felixlu4725/Carte-Diem/cart_tracking/cart1raw_path.png

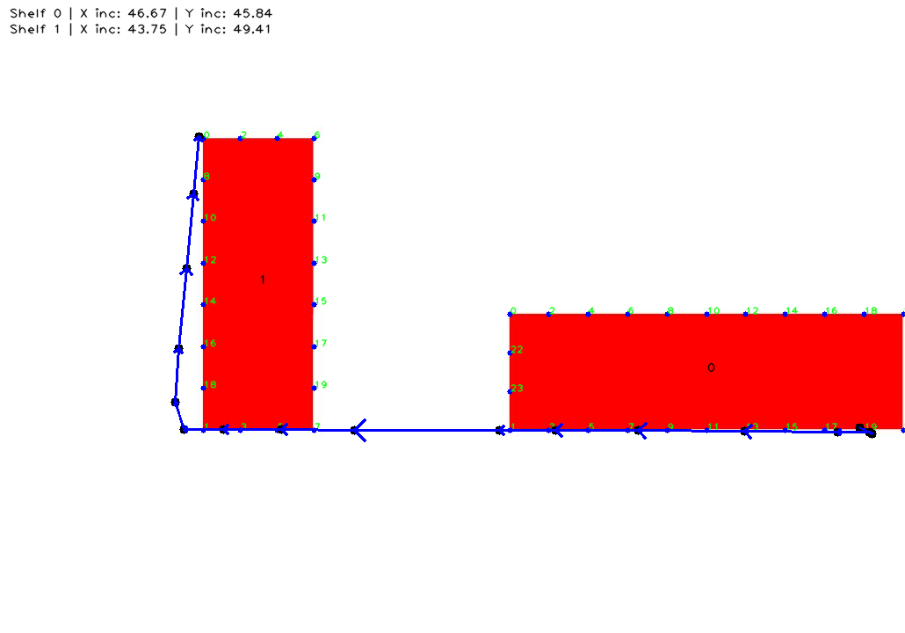
cart_tracking/cart1raw_path.png
