felixlu4725/Carte-Diem/cart_tracking/cart_heat_map.png

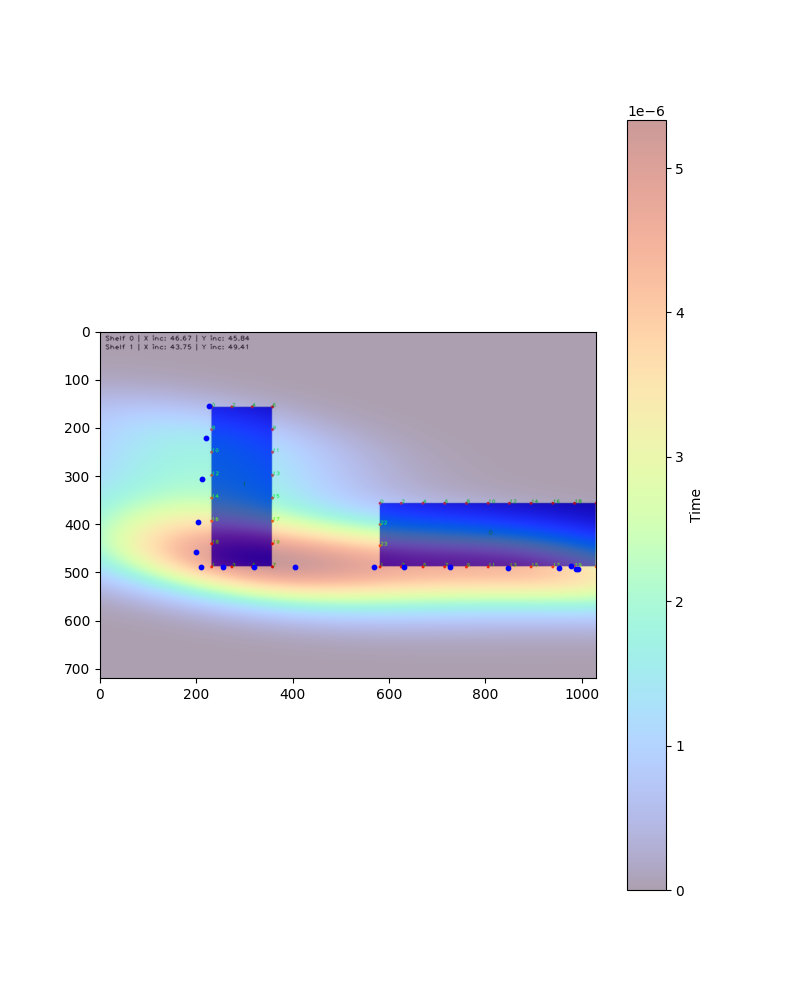
cart_tracking/cart_heat_map.png
