felixlu4725/Carte-Diem/cart_tracking/combined_heat_map.png

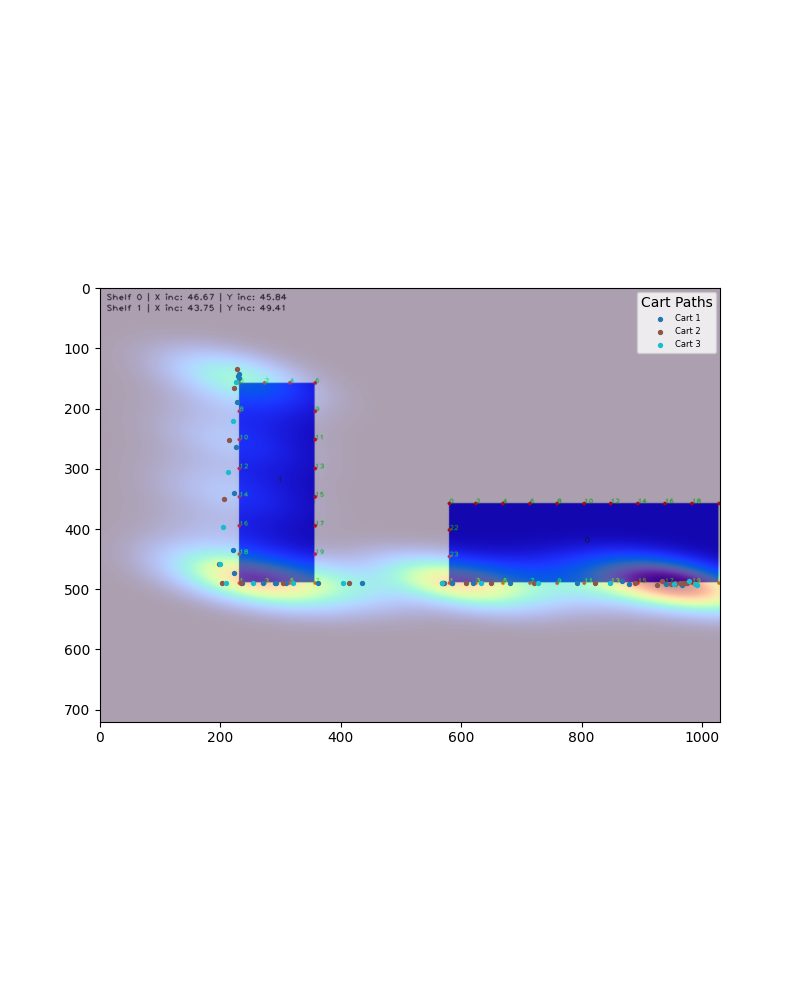
cart_tracking/combined_heat_map.png
