felixlu4725/Carte-Diem/cart_tracking/grocery_store.png

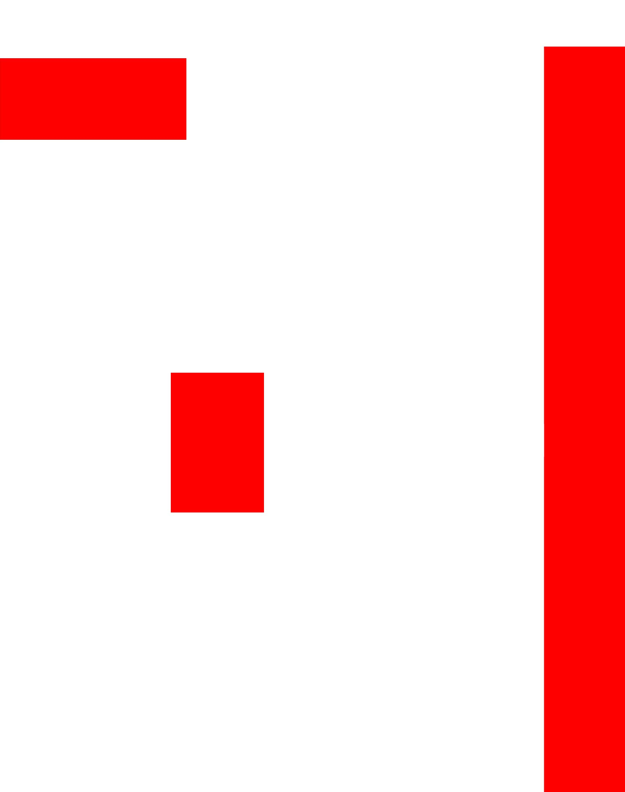
cart_tracking/grocery_store.png
