felixlu4725/Carte-Diem/cart_tracking/mapped.jpg

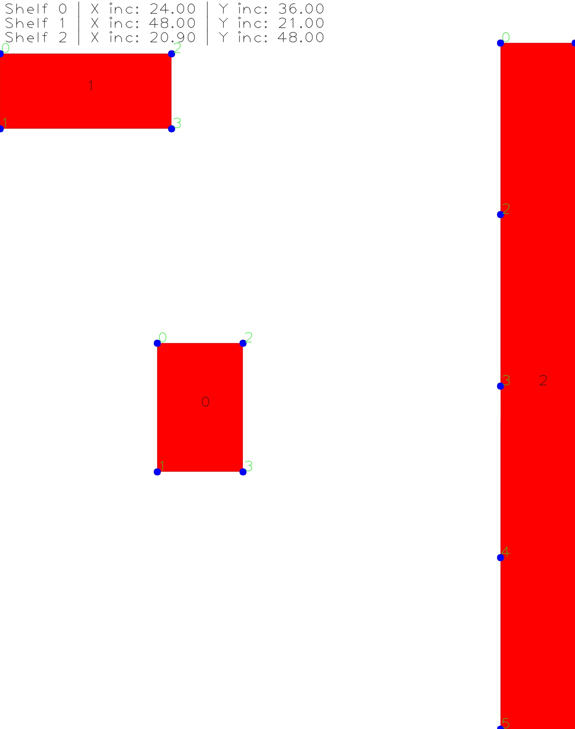
cart_tracking/mapped.jpg
