felixlu4725/Carte-Diem/cart_tracking/store1.png

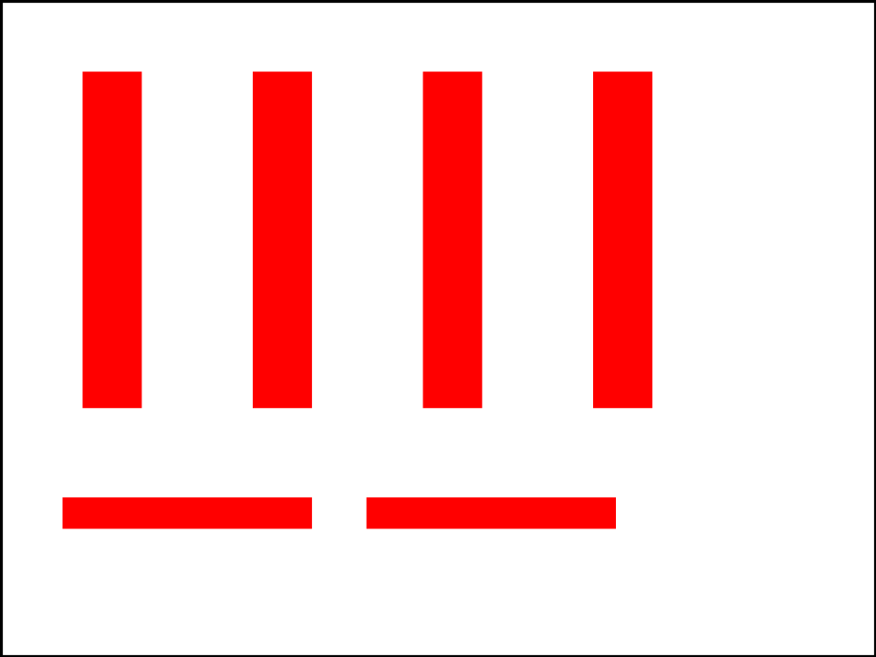
cart_tracking/store1.png
