felixlu4725/Carte-Diem/cart_tracking/store2.png

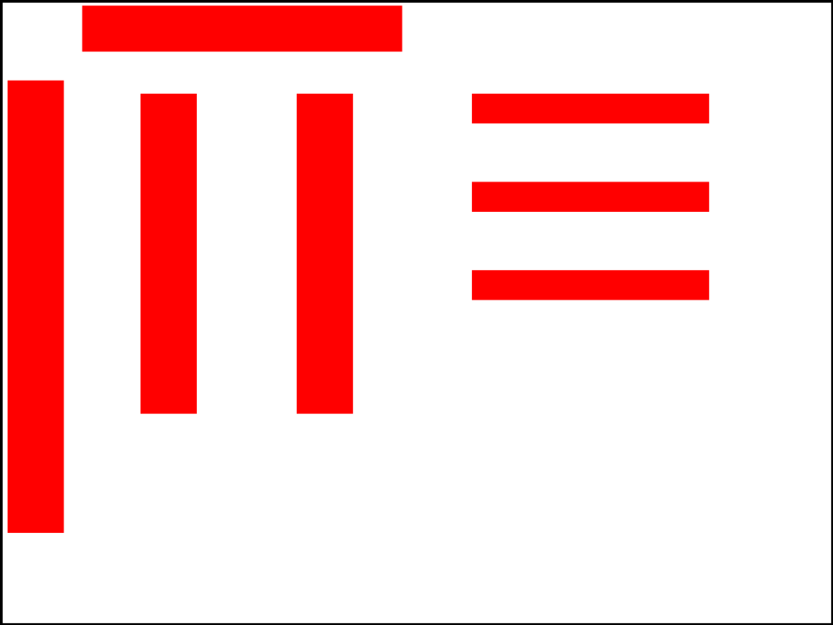
cart_tracking/store2.png
