felixlu4725/Carte-Diem/cart_tracking/store3.png

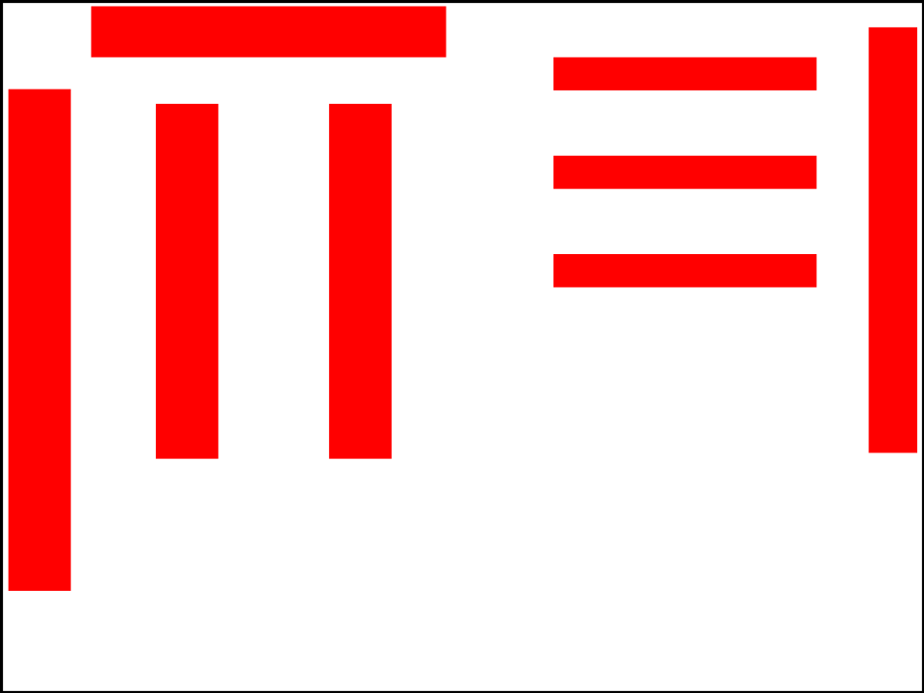
cart_tracking/store3.png
