felixlu4725/Carte-Diem/CAD/Hand Scanner Final.step

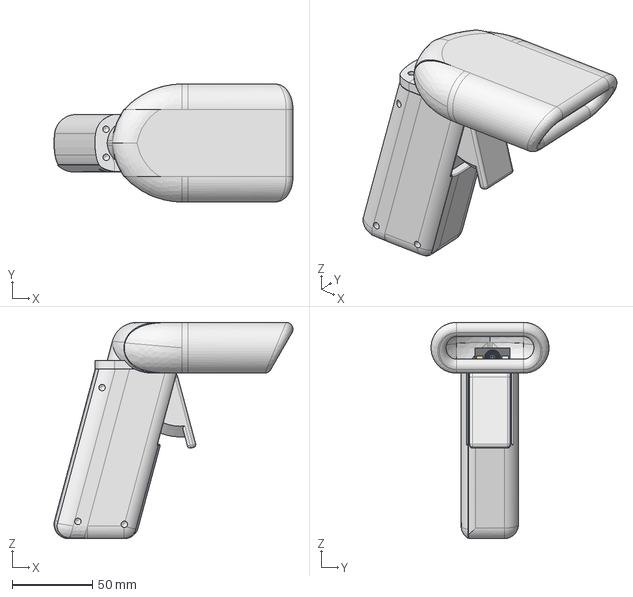
[picture p11: CAD file, 2025-12-08]
CAD/Hand Scanner Final.step
149.0 x 73.6 x 134.8 mm
