felixlu4725/Carte-Diem/PCB/Custom_Library/StepFiles/LT1764AEQPBF.step

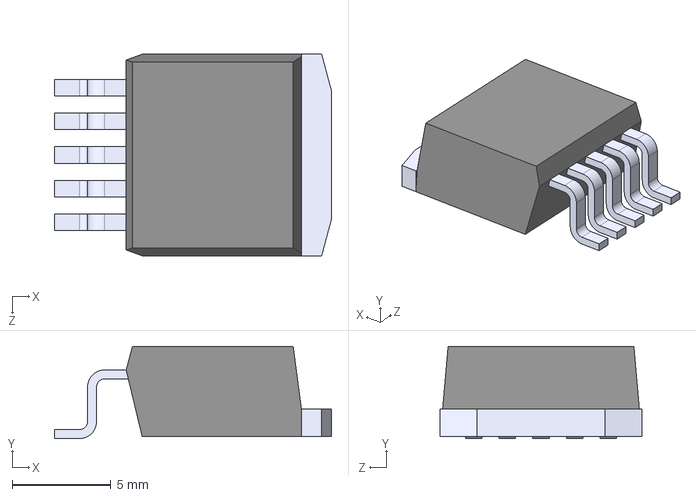
[picture p12: CAD file, 2025-12-08]
PCB/Custom_Library/StepFiles/LT1764AEQPBF.step
14.0 x 4.67 x 10.2 mm
