felixlu4725/Carte-Diem/PCB/Custom_Library/StepFiles/USB4120-03-C_REVA.step

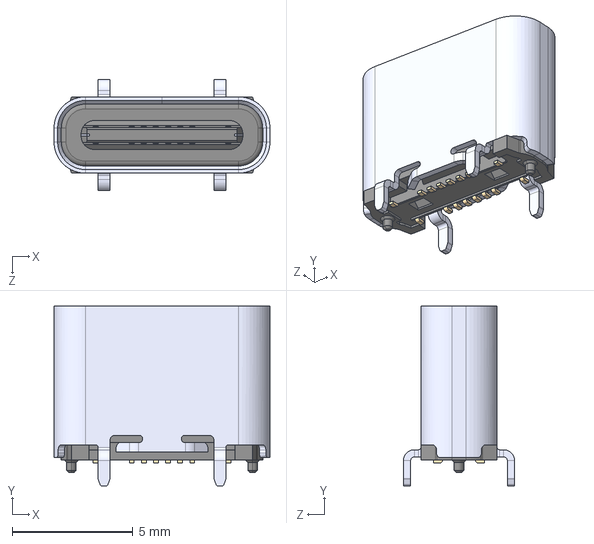
[picture p13: CAD file, 2025-12-08]
PCB/Custom_Library/StepFiles/USB4120-03-C_REVA.step
8.94 x 7.45 x 4.60 mm
