felixlu4725/Carte-Diem/PCB/Custom_Library/StepFiles/MF-MSMF010-2.step

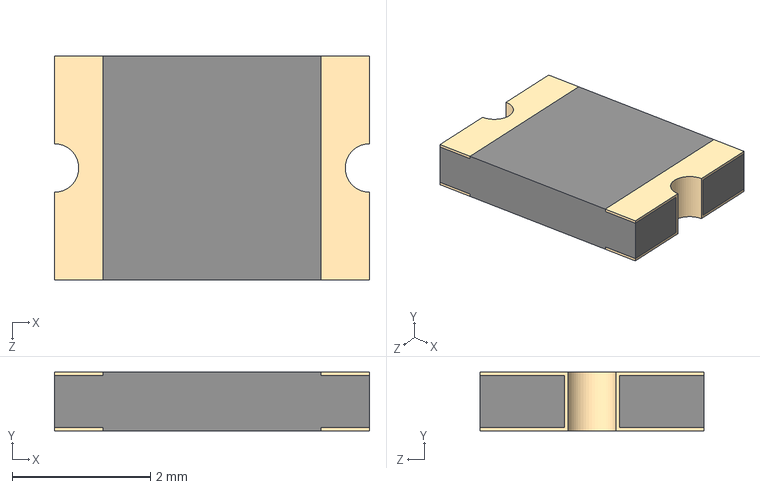
[picture p14: CAD file, 2025-12-08]
PCB/Custom_Library/StepFiles/MF-MSMF010-2.step
4.55 x 0.85 x 3.24 mm
