felixlu4725/Carte-Diem/PCB/Custom_Library/StepFiles/XT60PW-M.step

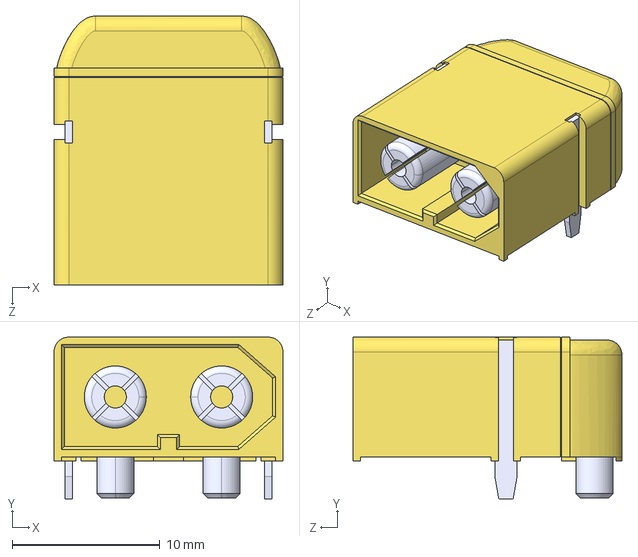
[picture p15: CAD file, 2025-12-08]
PCB/Custom_Library/StepFiles/XT60PW-M.step
15.5 x 10.9 x 18.2 mm
