felixlu4725/Carte-Diem/PCB/Custom_Library/StepFiles/USB4105GFA.step

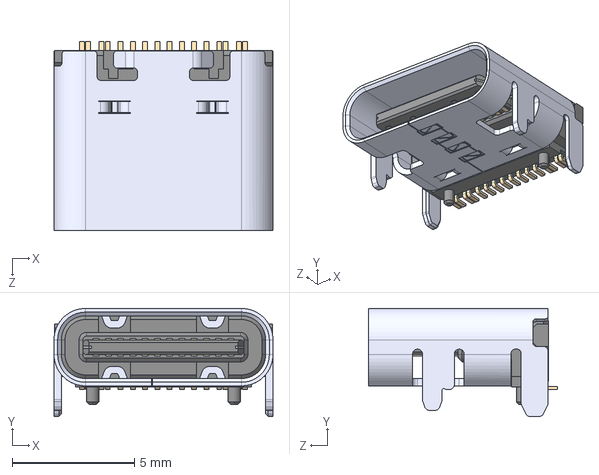
[picture p16: CAD file, 2025-12-08]
PCB/Custom_Library/StepFiles/USB4105GFA.step
8.94 x 4.41 x 7.71 mm
