felixlu4725/Carte-Diem/PCB/Custom_Library/StepFiles/SO14_DIO.step

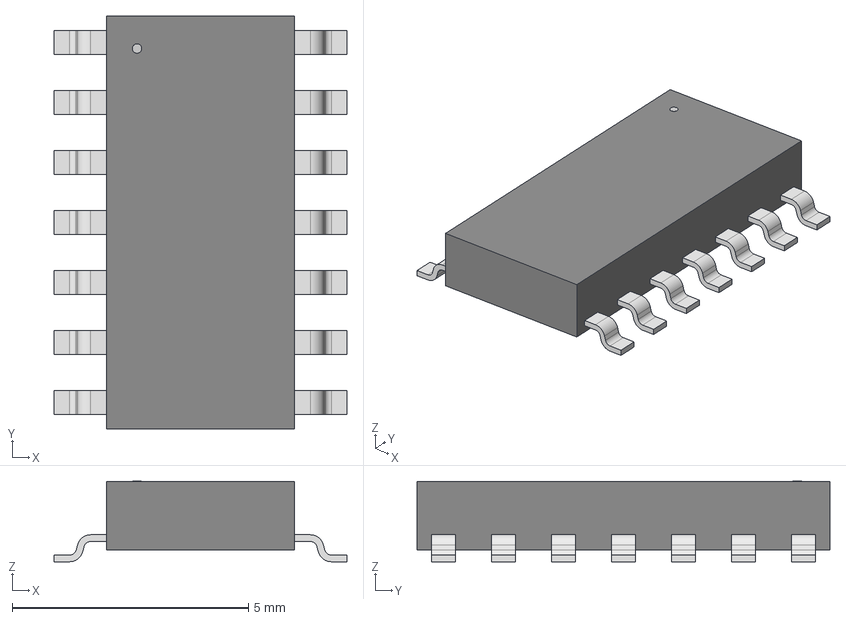
[picture p17: CAD file, 2025-12-08]
PCB/Custom_Library/StepFiles/SO14_DIO.step
6.20 x 8.74 x 1.70 mm
