felixlu4725/Carte-Diem/cart_tracking/test.bmp

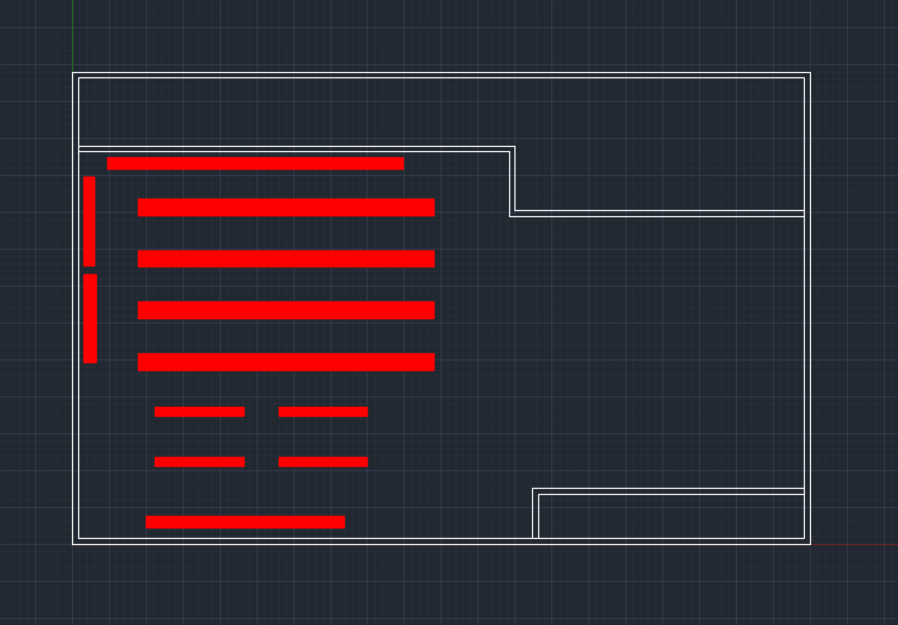
cart_tracking/test.bmp
