felixlu4725/Carte-Diem/cart_tracking/test-Model.pdf

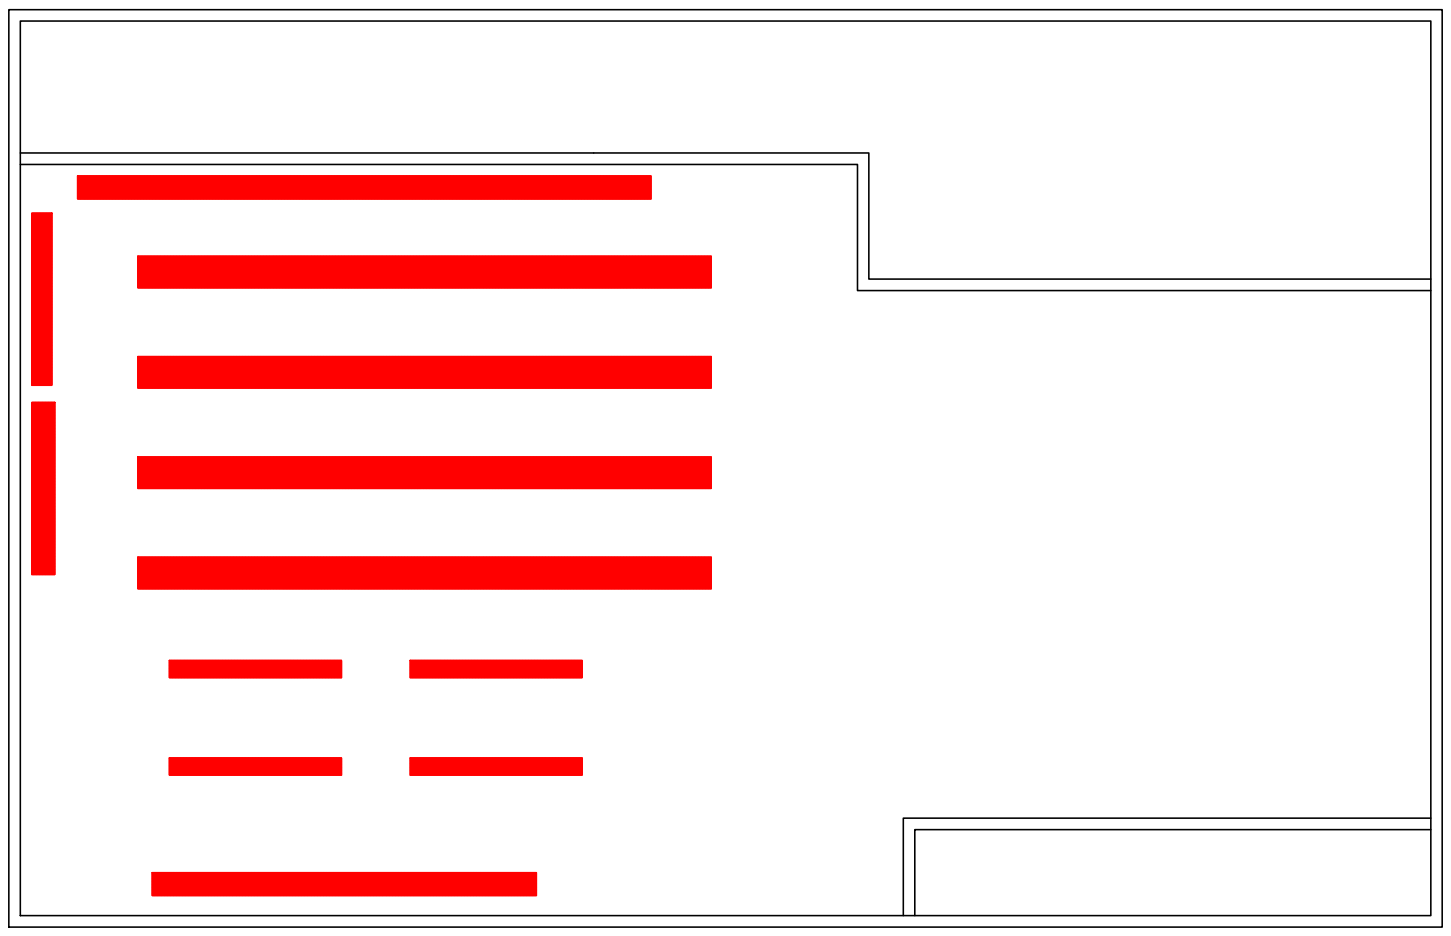
[picture p19: page 1]
