felixlu4725/Carte-Diem/PCB/CartDiem_STM.kicad_pcb

## KiCad design PCB/CartDiem_STM.kicad_pcb (2025-12-08)

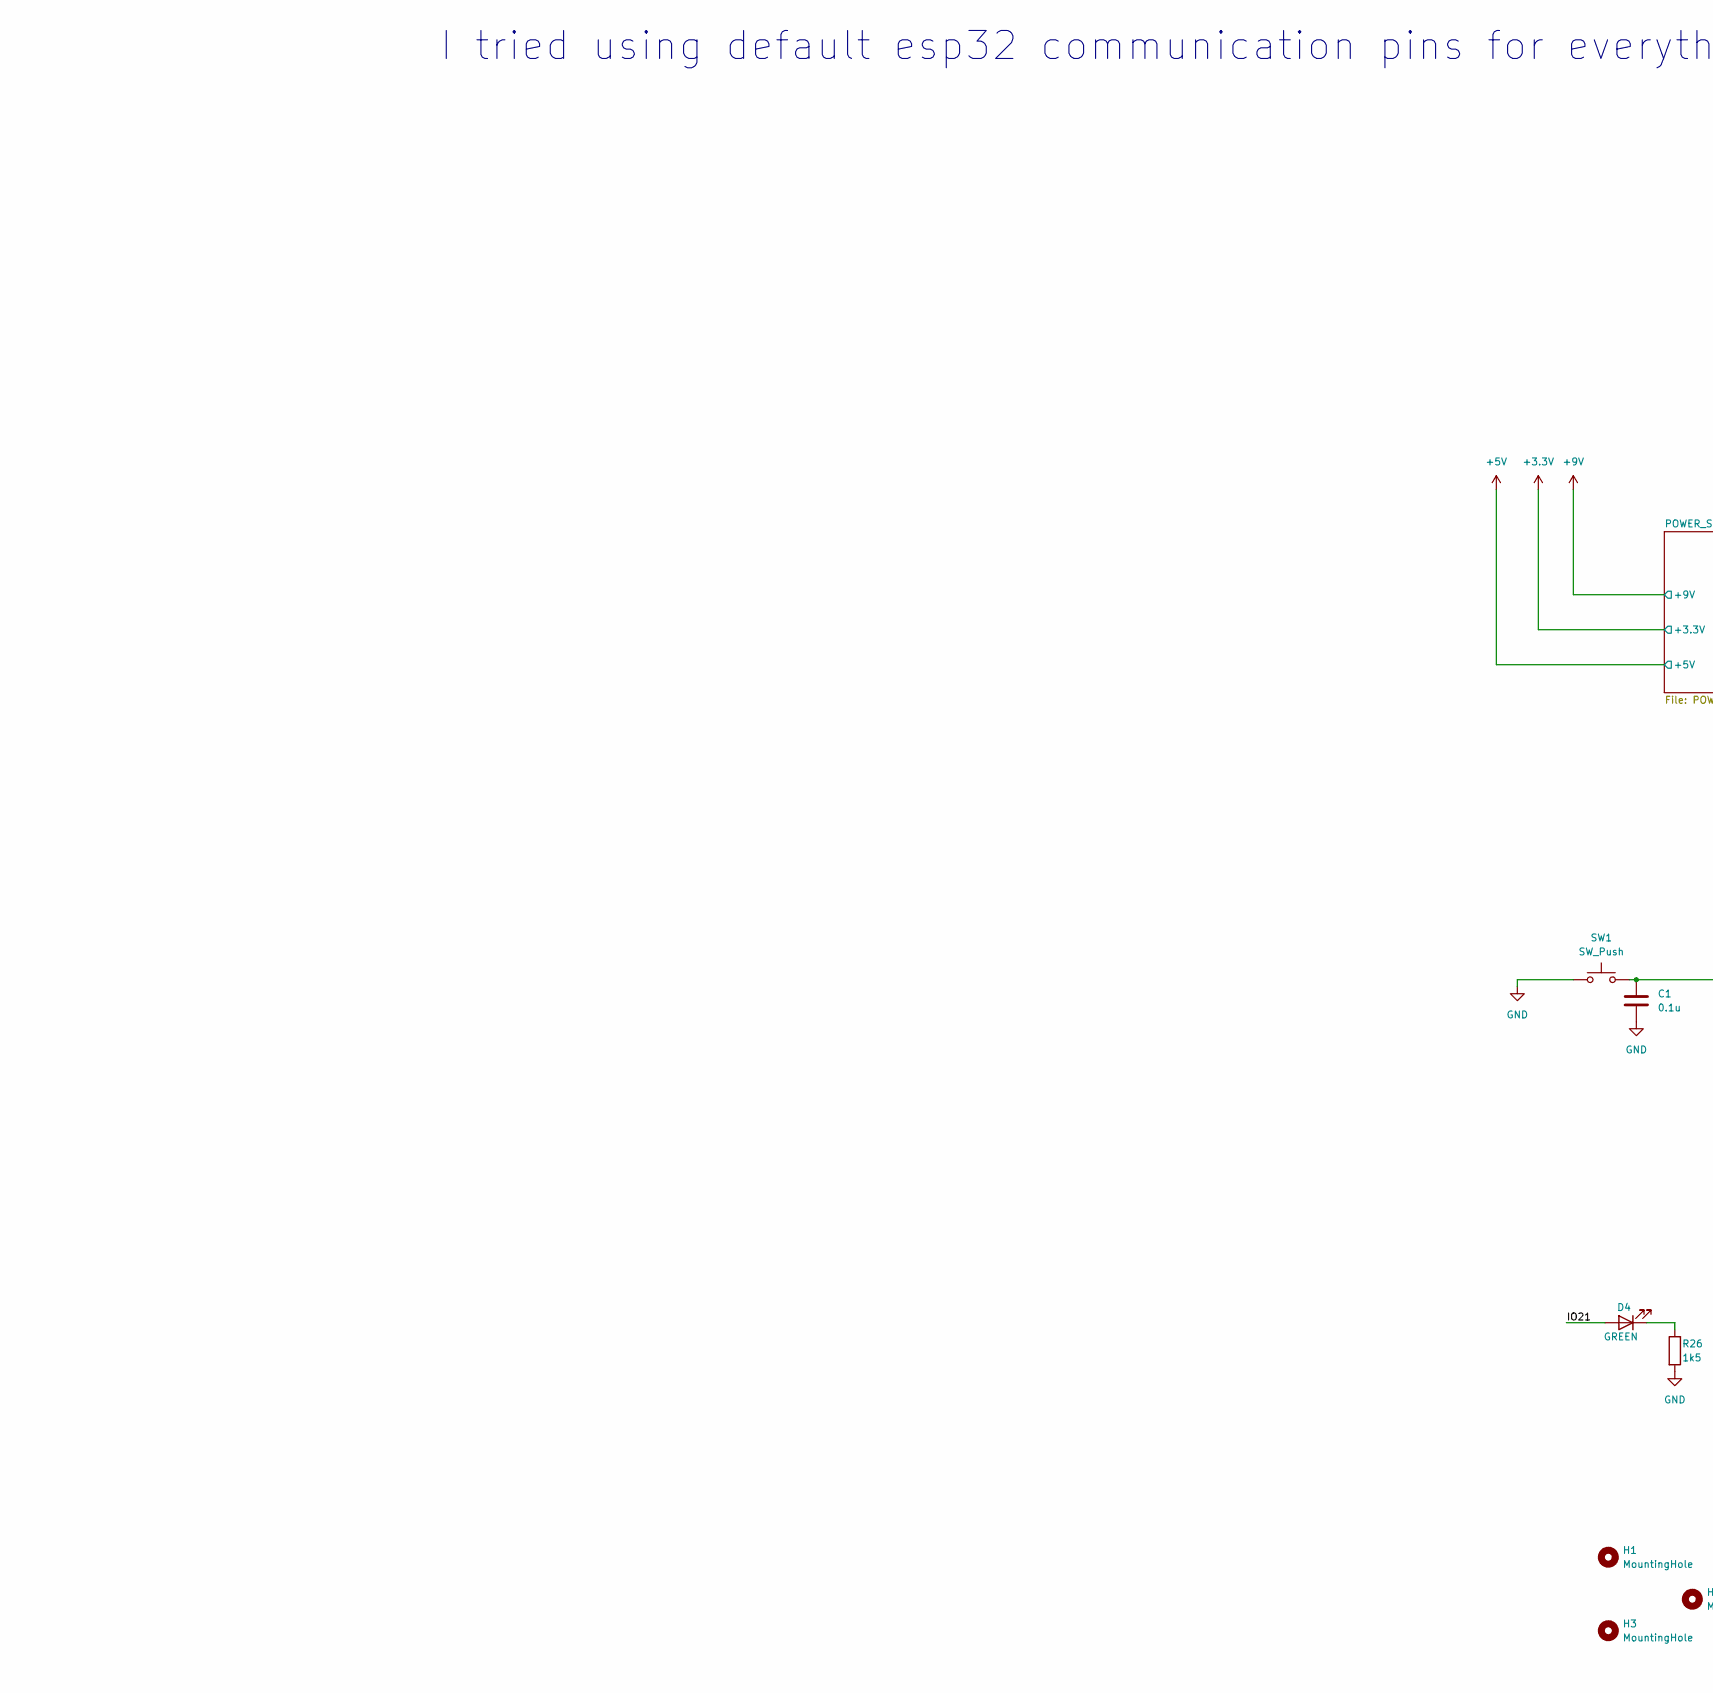
[picture p20: schematic CartDiem_STM.kicad_sch, part in row 1, column 1]

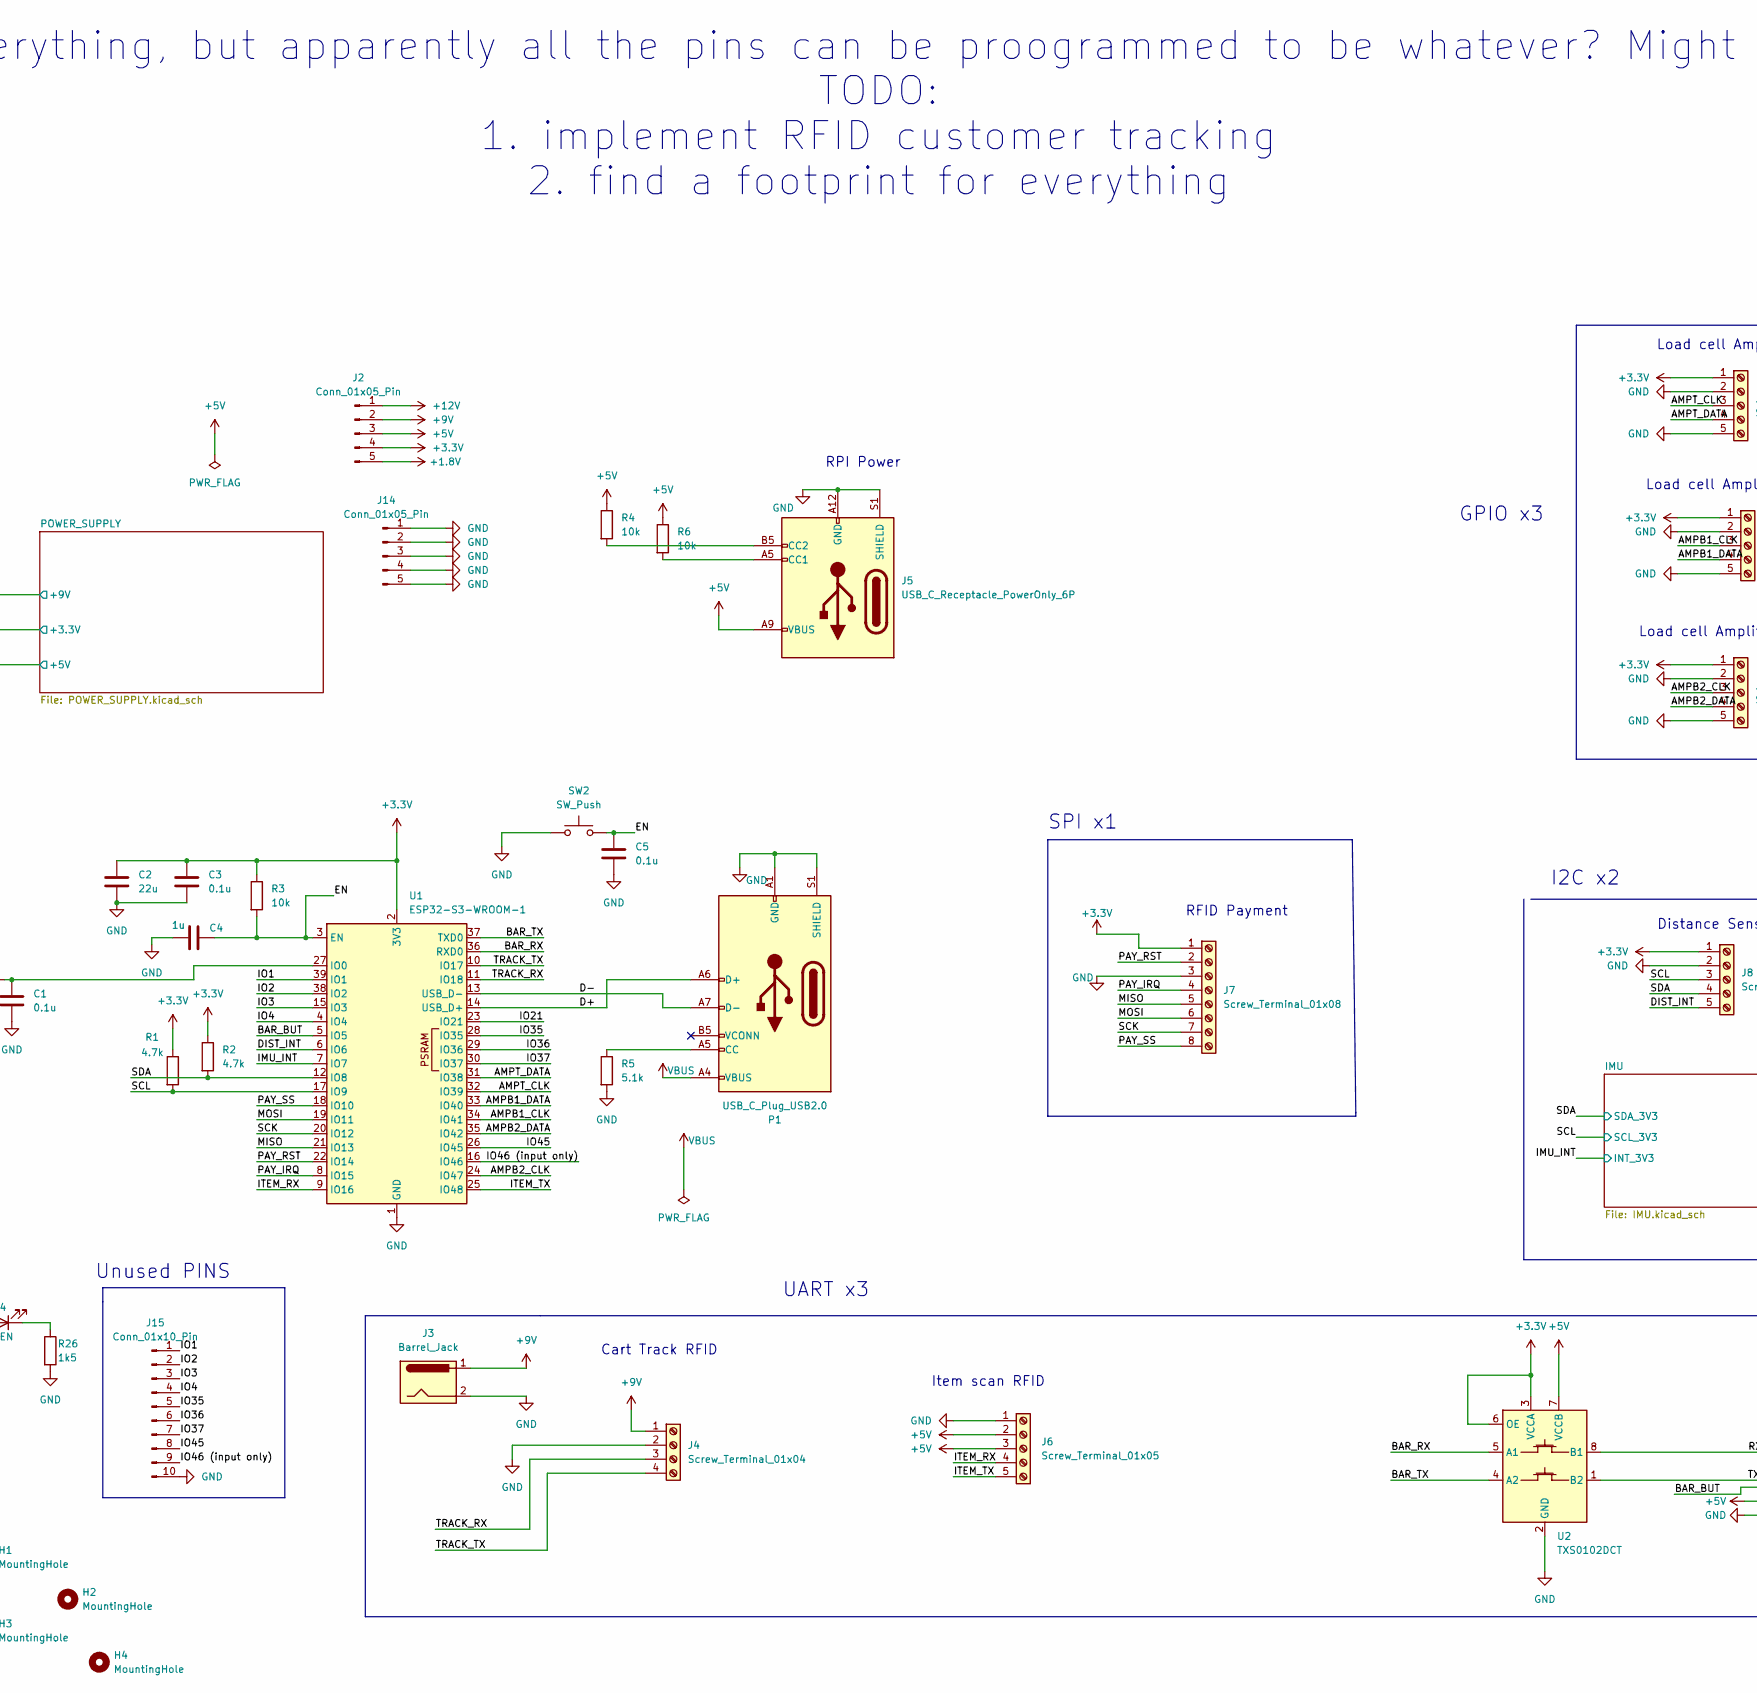
[picture p21: schematic CartDiem_STM.kicad_sch, part in row 1, column 2]

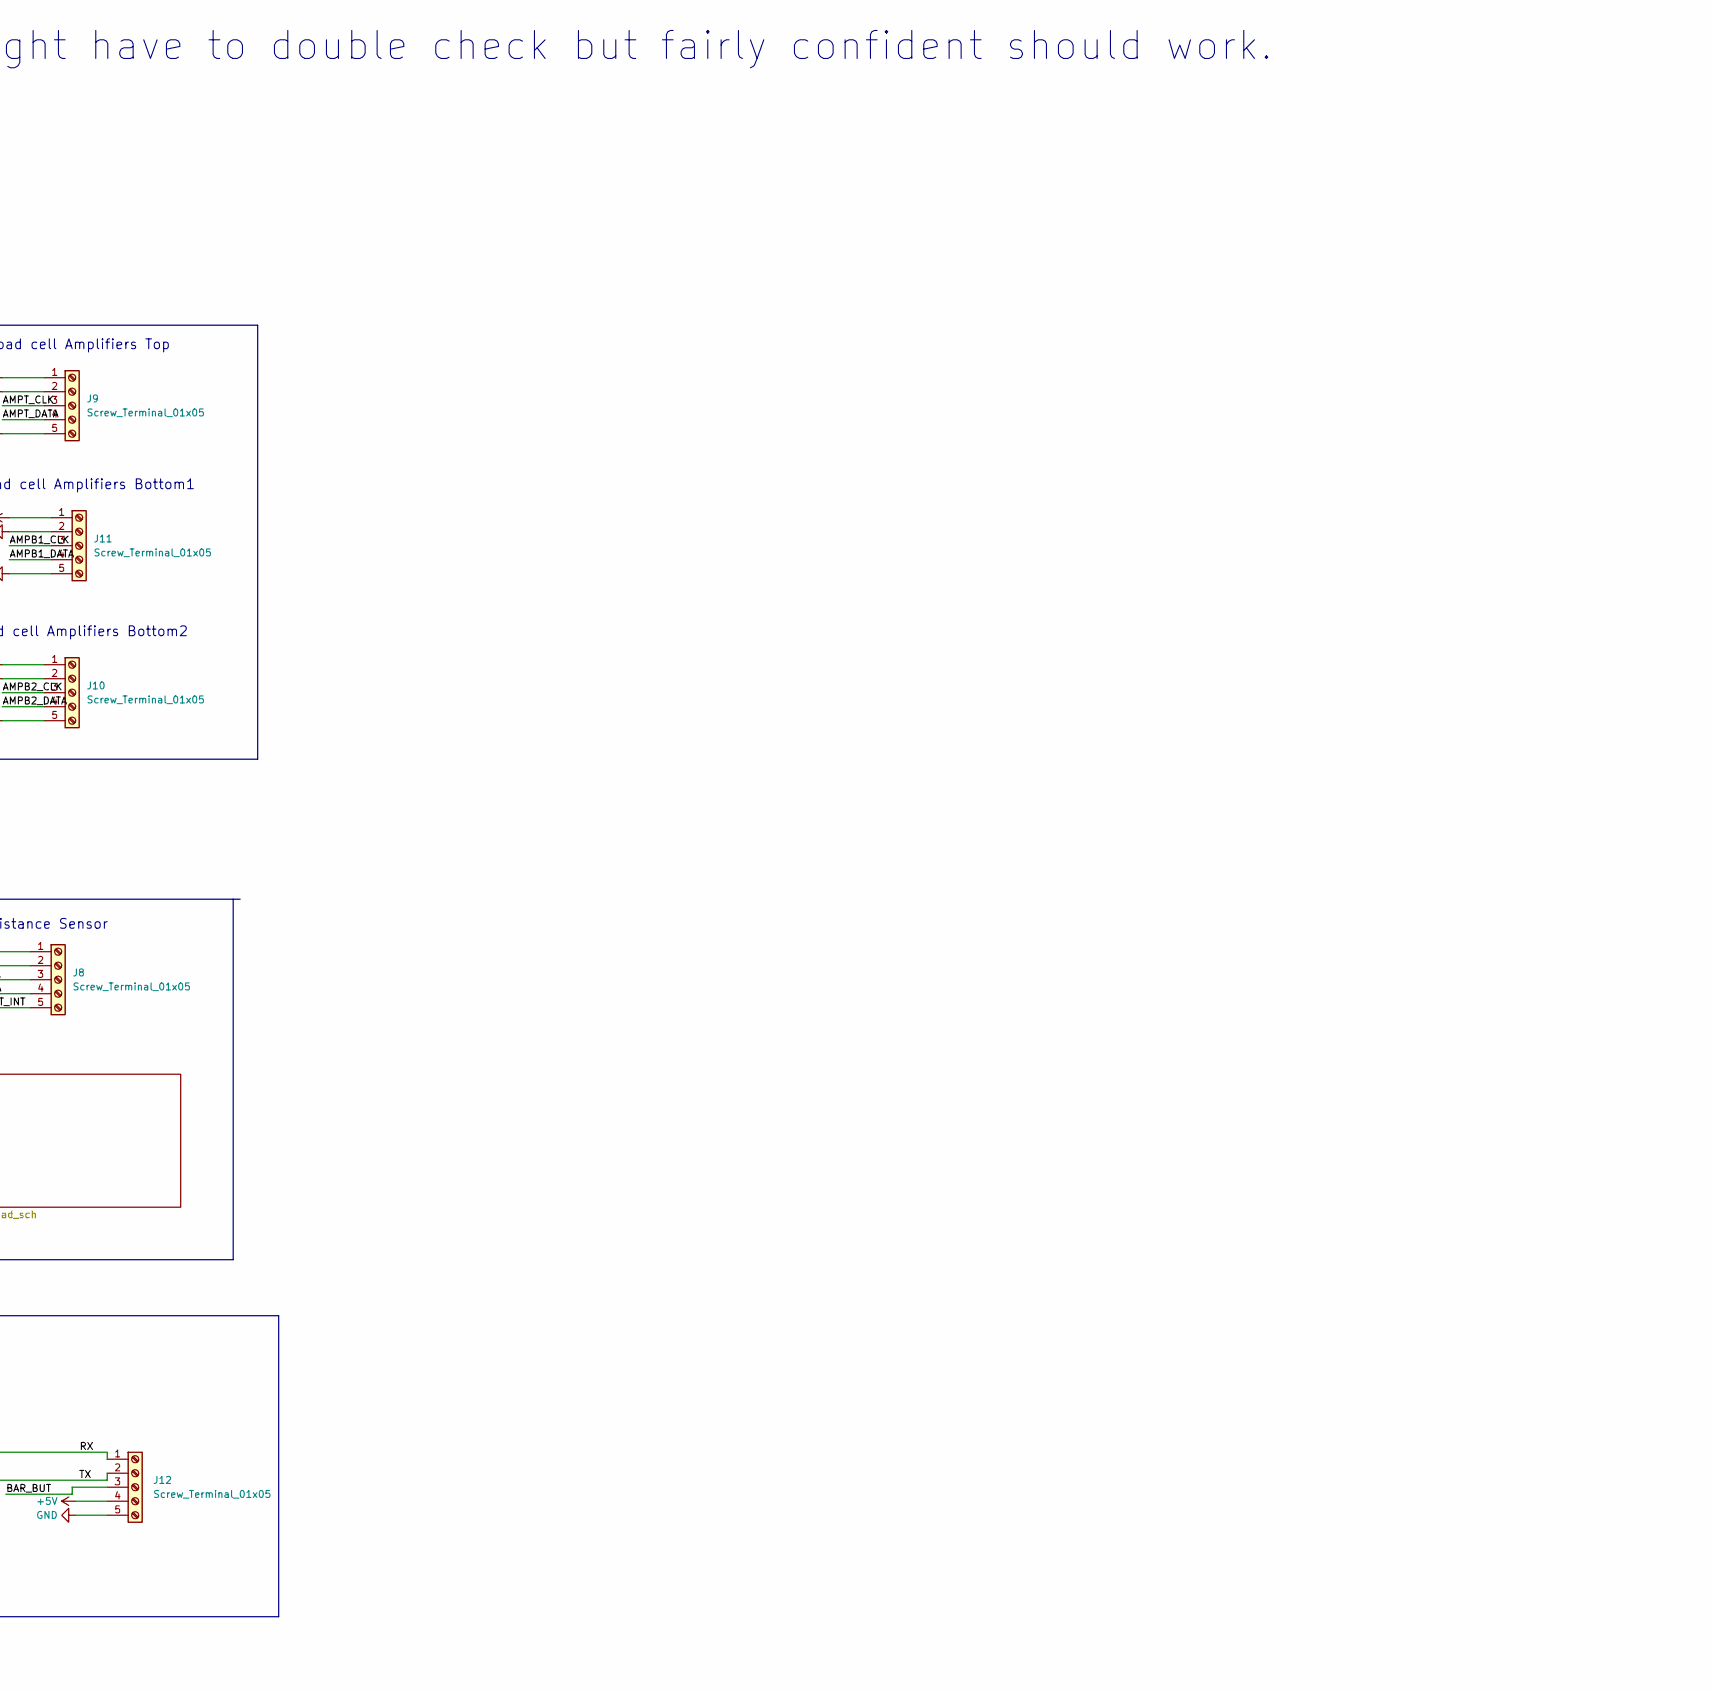
[picture p22: schematic CartDiem_STM.kicad_sch, part in row 1, column 3]

Parts:
C1, C3, C5: 0.1u; C_0603_1608Metric
C2: 22u; C_1210_3225Metric
C4: 1u; C_0603_1608Metric
D4: GREEN; LED_0603_1608Metric
H1, H2, H3, H4: MountingHole; MountingHole_3.2mm_M3
J2, J14: Conn_01x05_Pin; PinHeader_1x05_P2.54mm_Vertical
J3: Barrel_Jack; BarrelJack_CUI_PJ-063AH_Horizontal
J4: Screw_Terminal_01x04; TerminalBlock_Xinya_XY308-2.54-4P_1x04_P2.54mm_Horizontal
J5: USB_C_Receptacle_PowerOnly_6P; USB_C_Receptacle_GCT_USB4125-xx-x-0190_6P_TopMnt_Horizontal
J6, J8, J9, J10, J11, J12: Screw_Terminal_01x05; TerminalBlock_Xinya_XY308-2.54-5P_1x05_P2.54mm_Horizontal
J7: Screw_Terminal_01x08; TerminalBlock_Xinya_XY308-2.54-8P_1x08_P2.54mm_Horizontal
J15: Conn_01x10_Pin; PinHeader_1x10_P2.54mm_Vertical
P1: USB_C_Plug_USB2.0; GCT_USB4120-03-C_REVA
R1, R2: 4.7k; R_0603_1608Metric
R3, R4, R6: 10k; R_0603_1608Metric
R5: 5.1k; R_0603_1608Metric
R26: 1k5; R_0603_1608Metric
SW1, SW2: SW_Push; SW_Push_1P1T_XKB_TS-1187A
U1: ESP32-S3-WROOM-1
U2: TXS0102DCT; SSOP-8_2.95x2.8mm_P0.65mm

Connections:
+1.8V: J2.5; also elsewhere on the board
+3.3V: C2.1, C3.1, J2.4, J7.1, J8.1, J9.1, J10.1, J11.1, R1.1, R2.1, R3.1, U1.2 (3V3), U2.3 (VCCA), U2.6 (OE); also elsewhere on the board
+5V: J2.3, J5.A9 (VBUS), J5.B9 (VBUS), J6.2, J6.3, J12.4, R4.1, R6.1, U2.7 (VCCB); also elsewhere on the board
+9V: J2.2, J3.1, J4.1; also elsewhere on the board
+12V: J2.1; also elsewhere on the board
/AMPB1_CLK: J11.3, U1.34 (IO41)
/AMPB1_DATA: J11.4, U1.33 (IO40)
/AMPB2_CLK: J10.3, U1.24 (IO47)
/AMPB2_DATA: J10.4, U1.35 (IO42)
/AMPT_CLK: J9.3, U1.32 (IO39)
/AMPT_DATA: J9.4, U1.31 (IO38)
/BAR_BUT: J12.3, U1.5 (IO5)
/BAR_RX: U1.36 (RXD0), U2.5 (A1)
/BAR_TX: U1.37 (TXD0), U2.4 (A2)
/D+: P1.A6 (D+), U1.14 (USB_D+)
/D-: P1.A7 (D-), U1.13 (USB_D-)
/DIST_INT: J8.5, U1.6 (IO6)
/EN: C4.2, C5.1, R3.2, SW2.2, U1.3 (EN)
/IMU_INT: U1.7 (IO7); also elsewhere on the board
/IO1: J15.1, U1.39 (IO1)
/IO2: J15.2, U1.38 (IO2)
/IO3: J15.3, U1.15 (IO3)
/IO4: J15.4, U1.4 (IO4)
/IO21: D4.2 (A), U1.23 (IO21)
/IO35: J15.5, U1.28 (IO35)
/IO36: J15.6, U1.29 (IO36)
/IO37: J15.7, U1.30 (IO37)
/IO45: J15.8, U1.26 (IO45)
/IO46 (input only): J15.9, U1.16 (IO46)
/ITEM_RX: J6.4, U1.9 (IO16)
/ITEM_TX: J6.5, U1.25 (IO48)
/MISO: J7.5, U1.21 (IO13)
/MOSI: J7.6, U1.19 (IO11)
/PAY_IRQ: J7.4, U1.8 (IO15)
/PAY_RST: J7.2, U1.22 (IO14)
/PAY_SS: J7.8, U1.18 (IO10)
/RX: J12.1, U2.8 (B1)
/SCK: J7.7, U1.20 (IO12)
/SCL: J8.3, R1.2, U1.17 (IO9); also elsewhere on the board
/SDA: J8.4, R2.2, U1.12 (IO8); also elsewhere on the board
/TRACK_RX: J4.3, U1.11 (IO18)
/TRACK_TX: J4.4, U1.10 (IO17)
/TX: J12.2, U2.1 (B2)
GND: C1.2, C2.2, C3.2, C4.1, C5.2, J3.2, J4.2, J5.A12 (GND), J5.B12 (GND), J5.S1 (SHIELD), J6.1, J7.3, J8.2, J9.2, J9.5, J10.2, J10.5, J11.2, J11.5, J12.5, J14.1, J14.2, J14.3, J14.4, J14.5, J15.10, P1.A1 (GND), P1.A12 (GND), P1.B1 (GND), P1.B12 (GND), P1.S1 (SHIELD), R5.2, R26.2, SW1.1, SW2.1, U1.1 (GND), U1.40 (GND), U1.41 (GND), U2.2 (GND); also elsewhere on the board
unnamed: D4.1 (K), R26.1
unnamed: J5.A5 (CC1), R6.2
unnamed: J5.B5 (CC2), R4.2
unnamed: P1.A5 (CC), R5.1
unnamed: C1.1, SW1.2, U1.27 (IO0)
VBUS: P1.A4 (VBUS), P1.A9 (VBUS), P1.B4 (VBUS), P1.B9 (VBUS); also elsewhere on the board

Notes on the sheet:
Item scan RFID
Unused PINS
Load cell Amplifiers Bottom2
RFID Payment
Cart Track RFID
Distance Sensor
SPI x1
Load cell Amplifiers Bottom1
UART x3
I tried using default esp32 communication pins for everything, but apparently all the pins can be proogrammed to be whatever? Might have to double check but fairly confident should work. TODO: 1. implement RFID customer tracking 2. find a footprint for everything
Load cell Amplifiers Top
GPIO x3
RPI Power
I2C x2

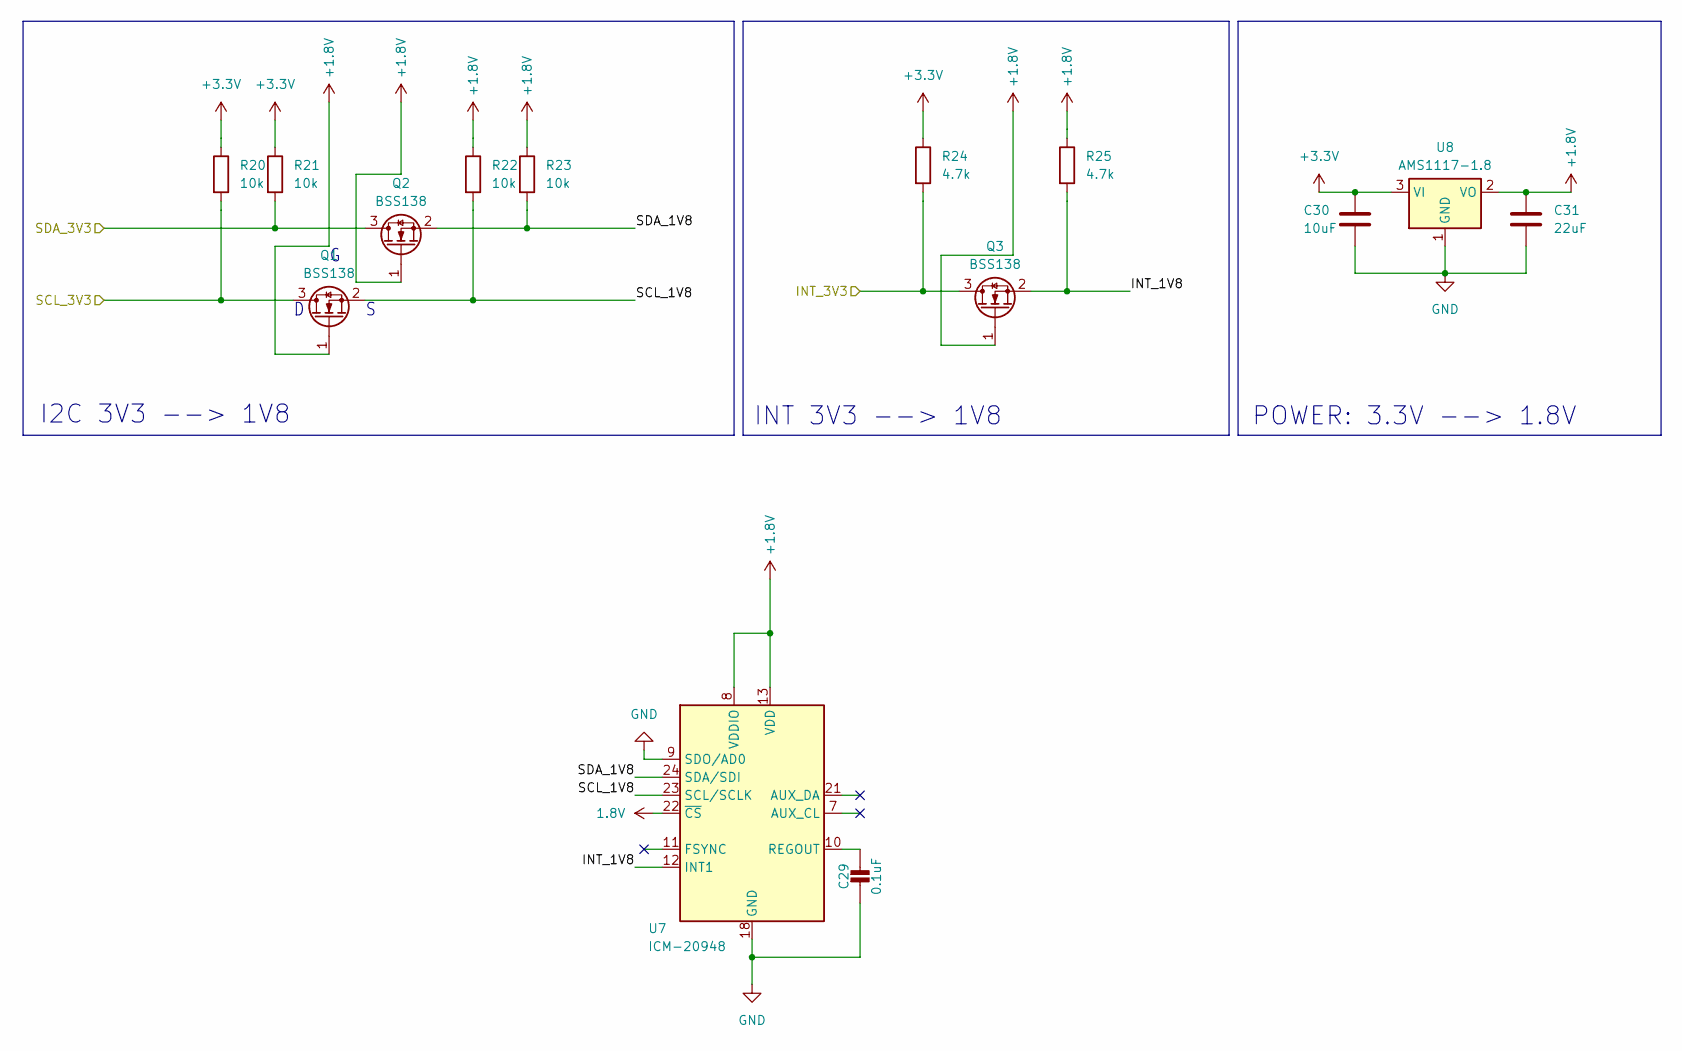
[picture p23: schematic IMU.kicad_sch]

Parts:
C29: 0.1uF; C_0603_1608Metric
C30: 10uF; C_0805_2012Metric
C31: 22uF; C_1210_3225Metric
Q1, Q2, Q3: BSS138; SOT-23
R20, R21, R22, R23: 10k; R_0603_1608Metric
R24, R25: 4.7k; R_0603_1608Metric
U7: ICM-20948; InvenSense_QFN-24_3x3mm_P0.4mm
U8: AMS1117-1.8; SOT-223-3_TabPin2

Connections:
1.8V: U7.22 (~CS)
+1.8V: C31.1, Q1.1 (G), Q2.1 (G), Q3.1 (G), R22.1, R23.1, R25.1, U7.8 (VDDIO), U7.13 (VDD), U8.2 (VO); also elsewhere on the board
+3.3V: C30.2, R20.1, R21.1, R24.1, U8.3 (VI); also elsewhere on the board
/IMU/INT_1V8: Q3.2 (S), R25.2, U7.12 (INT1)
/IMU/SCL_1V8: Q1.2 (S), R22.2, U7.23 (SCL/SCLK)
/IMU/SDA_1V8: Q2.2 (S), R23.2, U7.24 (SDA/SDI)
/IMU_INT: Q3.3 (D), R24.2; also elsewhere on the board
/SCL: Q1.3 (D), R20.2; also elsewhere on the board
/SDA: Q2.3 (D), R21.2; also elsewhere on the board
GND: C29.2, C30.1, C31.2, U7.9 (SDO/AD0), U7.18 (GND), U7.20 (GND), U8.1 (GND); also elsewhere on the board
unnamed: C29.1, U7.10 (REGOUT)

Notes on the sheet:
I2C 3V3 --> 1V8
INT 3V3 --> 1V8
POWER: 3.3V --> 1.8V

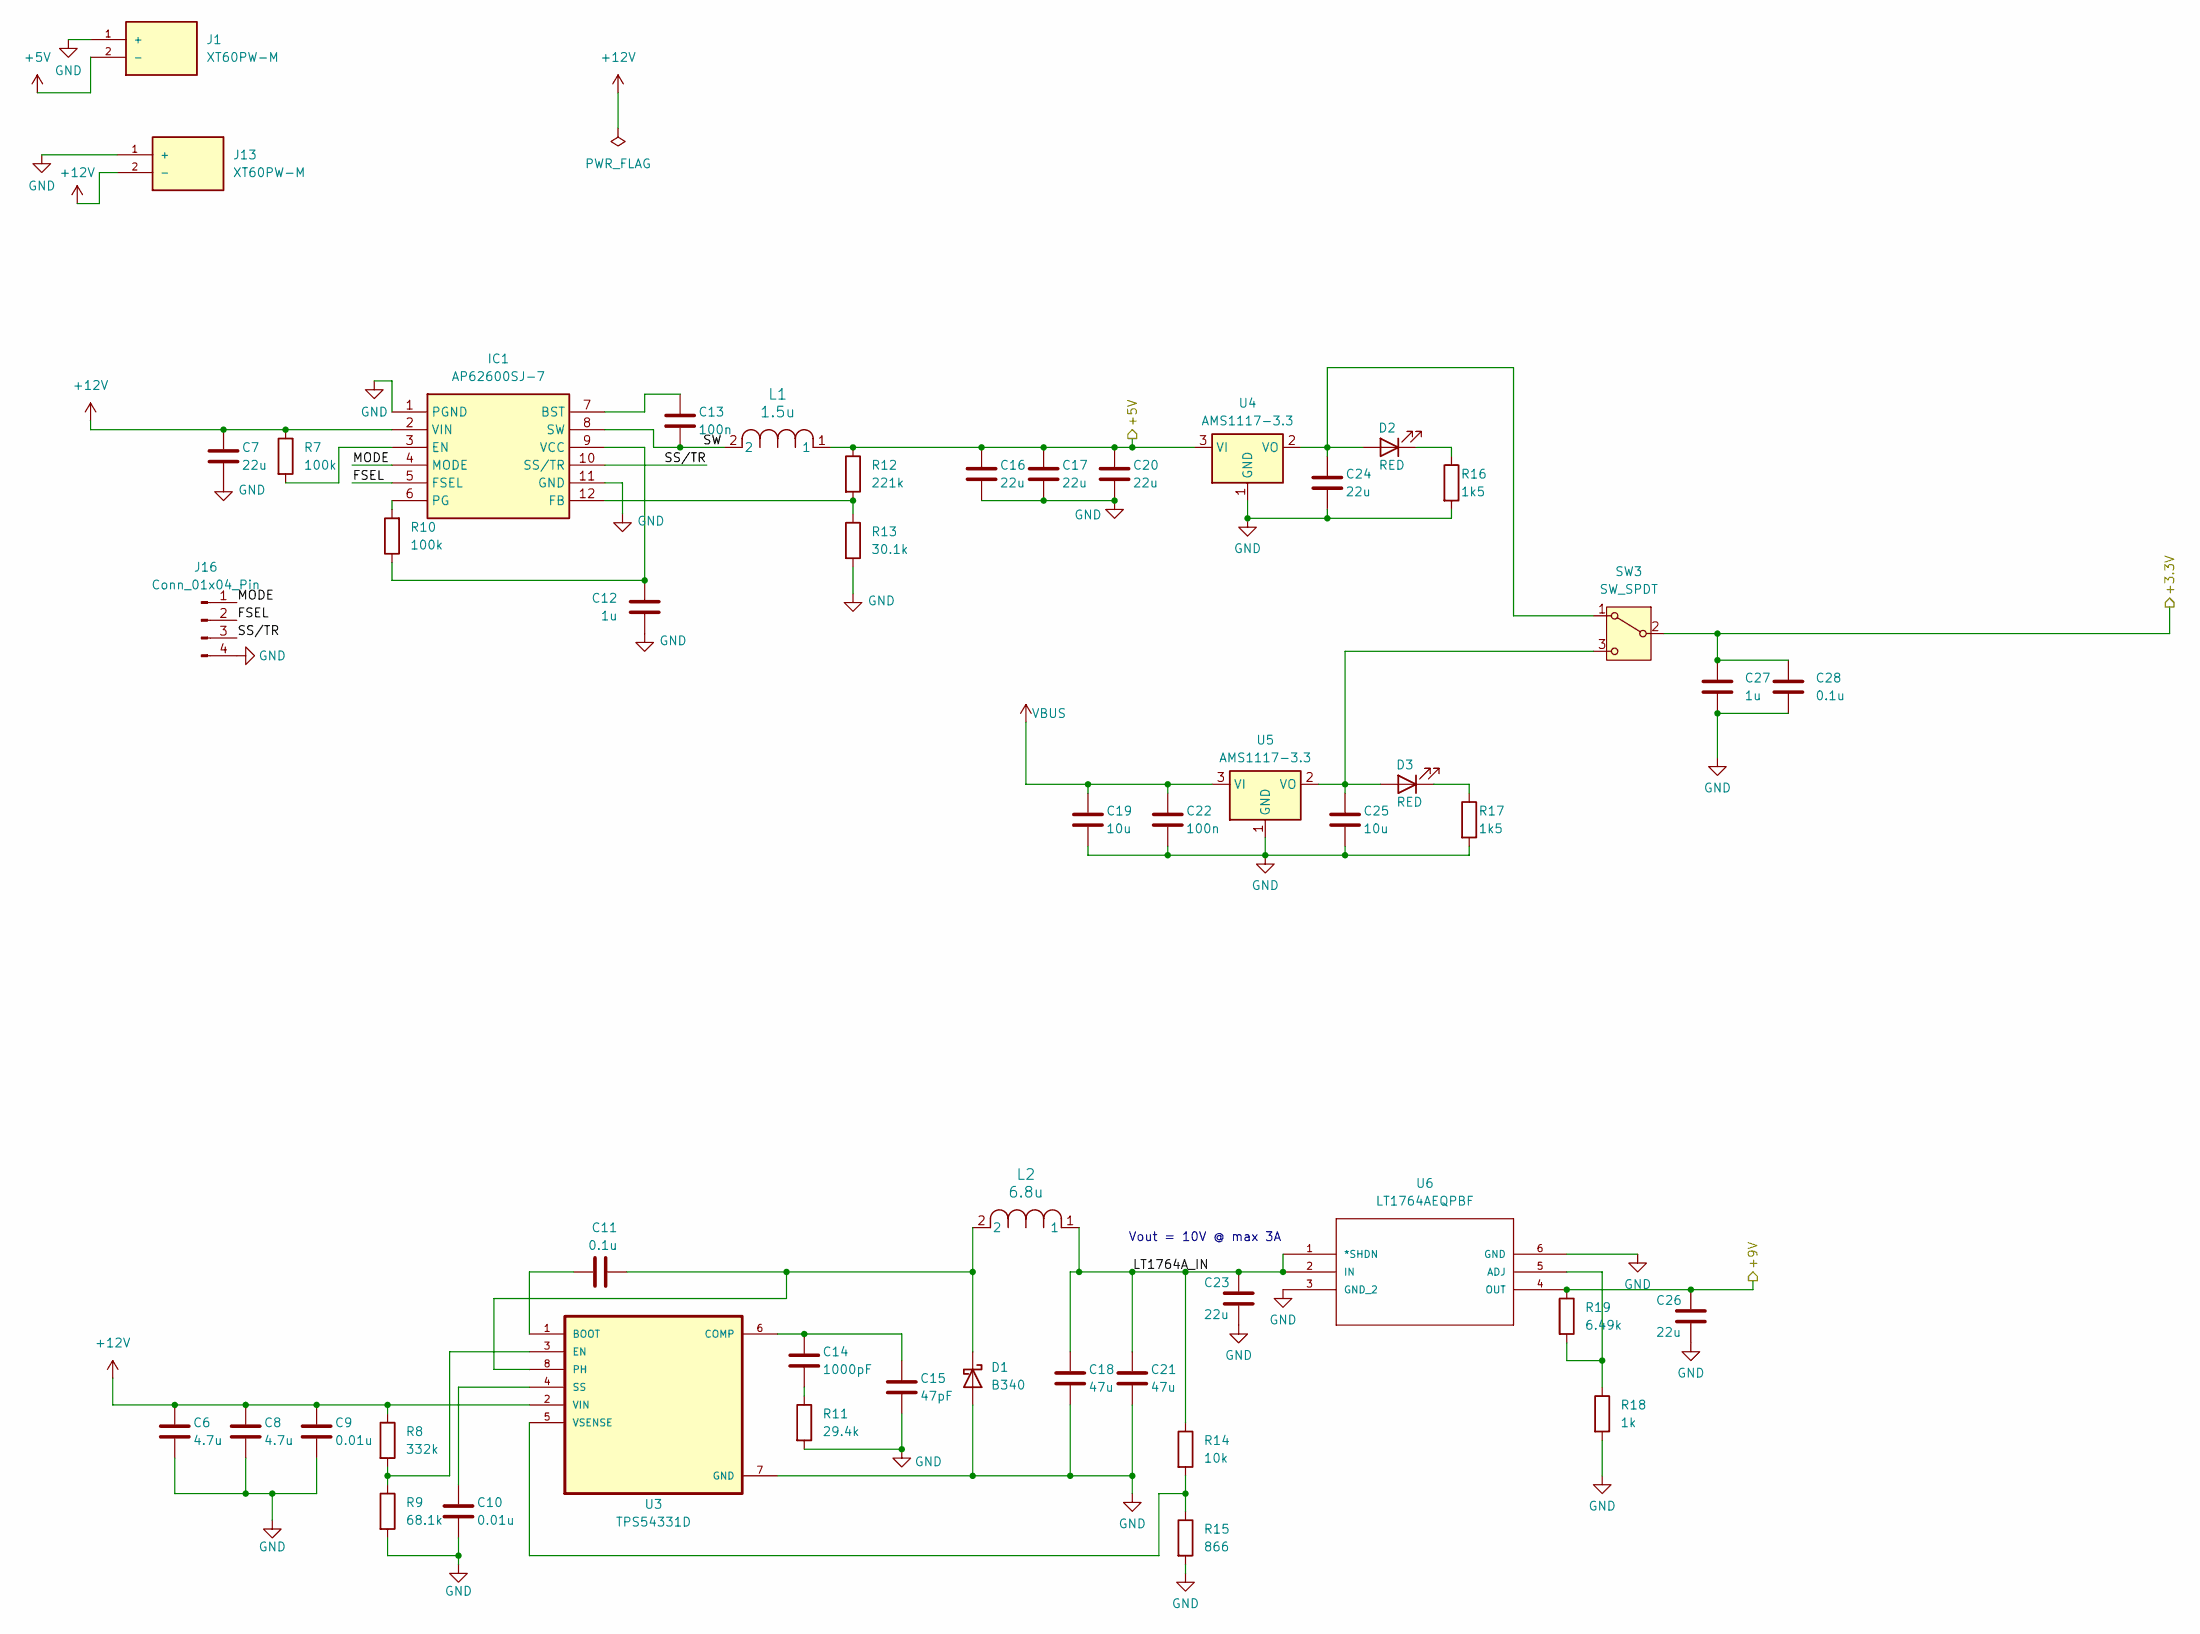
[picture p24: schematic POWER_SUPPLY.kicad_sch]

Parts:
C6, C8: 4.7u; C_0805_2012Metric
C7, C16, C17, C20: 22u; C_1210_3225Metric
C9, C10: 0.01u; C_0603_1608Metric
C11, C28: 0.1u; C_0603_1608Metric
C12, C27: 1u; C_0603_1608Metric
C13, C22: 100n; C_0805_2012Metric
C14: 1000pF; C_0603_1608Metric
C15: 47pF; C_0603_1608Metric
C18, C21: 47u; C_1210_3225Metric
C19, C25: 10u; C_0805_2012Metric
C23, C26: 22u; C_1206_3216Metric
C24: 22u; C_0805_2012Metric
D1: B340; D_SMC
D2, D3: RED; LED_0603_1608Metric
IC1: AP62600SJ-7; AP62600SJ7; Manufacturer_Part_Number AP62600SJ-7; Mouser Part Number 621-AP62600SJ-7
J1, J13: XT60PW-M; AMASS_XT60IPW-M_1x03_P7.20mm_Horizontal; PARTREV V1.2
J16: Conn_01x04_Pin; PinSocket_1x04_P2.54mm_Vertical
L1: 1.5u; L_Bourns_SRP6060FA
L2: 6.8u; L_Bourns_SRP6060FA
R7: 100k; R_0805_2012Metric
R8: 332k; R_0805_2012Metric
R9: 68.1k; R_0805_2012Metric
R10: 100k; R_0603_1608Metric
R11: 29.4k; R_0603_1608Metric
R12: 221k; R_0603_1608Metric
R13: 30.1k; R_0603_1608Metric
R14: 10k; R_0603_1608Metric
R15: 866; R_0603_1608Metric
R16, R17: 1k5; R_0603_1608Metric
R18: 1k; R_0603_1608Metric
R19: 6.49k; R_0603_1608Metric
SW3: SW_SPDT; SW_SPDT_PCM12
U3: TPS54331D; SOIC127P599X175-8N
U4, U5: AMS1117-3.3; SOT-223-3_TabPin2
U6: LT1764AEQPBF; DDPAK-5_Q; MANUFACTURER_PART_NUMBER LT1764AEQ#PBF; DIGIKEY_PART_NUMBER LT1764AEQ#PBFND

Connections:
+3.3V: C27.1, C28.1, SW3.2 (B); also elsewhere on the board
+5V: C16.1, C17.1, C20.1, J1.2 (-), L1.1, R12.1, U4.3 (VI); also elsewhere on the board
+9V: C26.1, R19.1, U6.4 (OUT); also elsewhere on the board
+12V: C6.1, C7.1, C8.1, C9.1, IC1.2 (VIN), J13.2 (-), R7.1, R8.1, U3.2 (VIN); also elsewhere on the board
/POWER_SUPPLY/FSEL: IC1.5 (FSEL), J16.2
/POWER_SUPPLY/LT1764A_IN: C18.1, C21.1, C23.1, L2.1, R14.1, U6.1 (*SHDN), U6.2 (IN)
/POWER_SUPPLY/MODE: IC1.4 (MODE), J16.1
/POWER_SUPPLY/SS/TR: IC1.10 (SS/TR), J16.3
/POWER_SUPPLY/SW: C13.2, IC1.8 (SW), L1.2
GND: C6.2, C7.2, C8.2, C9.2, C10.2, C12.1, C15.2, C16.2, C17.2, C18.2, C19.2, C20.2, C21.2, C22.2, C23.2, C24.2, C25.2, C26.2, C27.2, C28.2, D1.2 (A), IC1.1 (PGND), IC1.11 (GND), J1.1 (+), J13.1 (+), J16.4, R9.2, R11.2, R13.2, R15.2, R16.2, R17.2, R18.2, U3.7 (GND), U4.1 (GND), U5.1 (GND), U6.3 (GND_2), U6.6 (GND); also elsewhere on the board
unnamed: C14.2, R11.1
unnamed: C11.2, D1.1 (K), L2.2, U3.8 (PH)
unnamed: C24.1, D2.2 (A), SW3.1 (A), U4.2 (VO)
unnamed: D2.1 (K), R16.1
unnamed: C25.1, D3.2 (A), SW3.3 (C), U5.2 (VO)
unnamed: D3.1 (K), R17.1
unnamed: C13.1, IC1.7 (BST)
unnamed: IC1.3 (EN), R7.2
unnamed: IC1.12 (FB), R12.2, R13.1
unnamed: IC1.6 (PG), R10.2
unnamed: C12.2, IC1.9 (VCC), R10.1
unnamed: C11.1, U3.1 (BOOT)
unnamed: C14.1, C15.1, U3.6 (COMP)
unnamed: R8.2, R9.1, U3.3 (EN)
unnamed: C10.1, U3.4 (SS)
unnamed: R14.2, R15.1, U3.5 (VSENSE)
unnamed: R18.1, R19.2, U6.5 (ADJ)
VBUS: C19.1, C22.1, U5.3 (VI); also elsewhere on the board

Notes on the sheet:
Vout = 10V @ max 3A

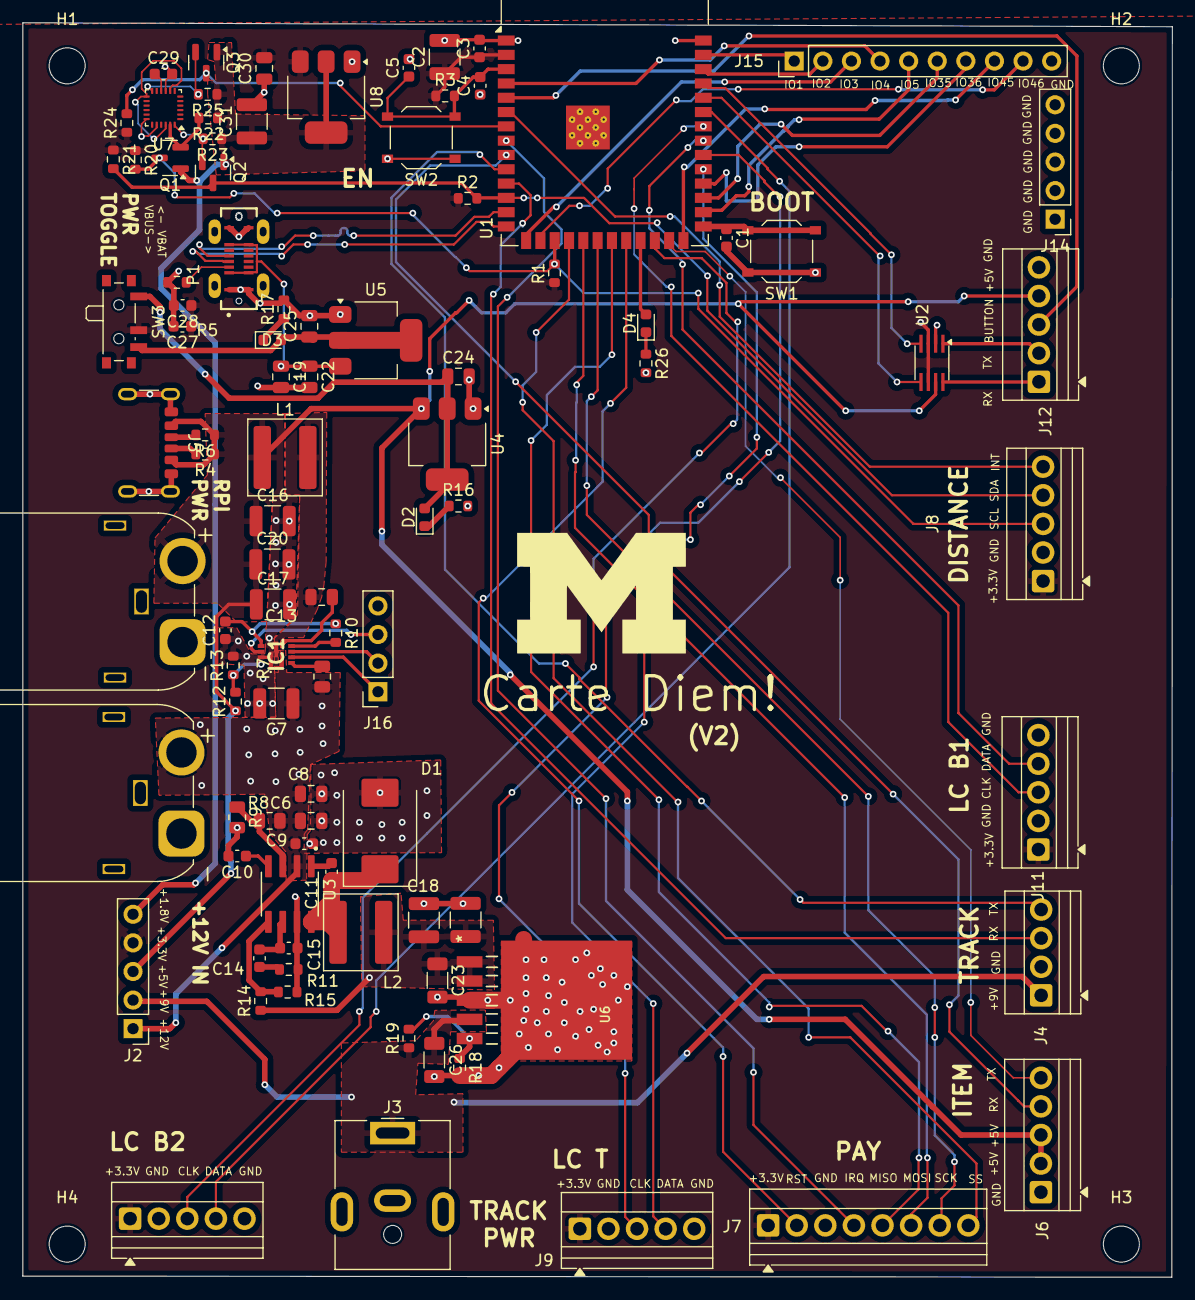
[picture p25: board CartDiem_STM.kicad_pcb from above]

Board: 2 copper layers, 102.1 x 111.4 mm, 99 parts (0 on the bottom side), 76 nets.
