felixlu4725/Carte-Diem/integration/main/interfaces/ble_barcode_nimble.c

#include "ble_barcode_nimble.h"
#include "esp_log.h"
#include "nvs_flash.h"
#include "freertos/FreeRTOS.h"
#include "freertos/task.h"
#include "nimble/nimble_port.h"
#include "nimble/nimble_port_freertos.h"
#include "host/ble_hs.h"
#include "host/util/util.h"
#include "services/gap/ble_svc_gap.h"
#include "services/gatt/ble_svc_gatt.h"
#include <string.h>

#define TAG "BLE_BARCODE"

// Custom UUIDs (128-bit, in reverse byte order for NimBLE)

// Service UUID: Using a custom service UUID
static const ble_uuid128_t gatt_svr_svc_cartediem_uuid = 
    BLE_UUID128_INIT(0x4f, 0xb1, 0x76, 0xb6, 0x4f, 0x79, 0x89, 0xb2,
                     0x89, 0x45, 0x7e, 0x1d, 0x80, 0x6c, 0x6b, 0xe3);

// UPC Characteristic UUID: e36b6c81-1d7e-4589-b289-794fb676b14f
static const ble_uuid128_t gatt_svr_chr_upc_uuid = 
    BLE_UUID128_INIT(0x4f, 0xb1, 0x76, 0xb6, 0x4f, 0x79, 0x89, 0xb2,
                     0x89, 0x45, 0x7e, 0x1d, 0x81, 0x6c, 0x6b, 0xe3);

// Cart tracking cart_tracking UUID: d5eabd06-05a6-4b8d-bb15-8393c3a703de
static const ble_uuid128_t gatt_svr_chr_cart_tracking_uuid =
    BLE_UUID128_INIT(0xde, 0x03, 0xa7, 0xc3, 0x93, 0x83, 0x15, 0xbb,
                     0x8d, 0x4b, 0xa6, 0x05, 0x06, 0xbd, 0xea, 0xd5);

// Payment success or failure UUID: 45ef2927-fd6a-4ba2-ab82-f3f5f27b7967
static const ble_uuid128_t gatt_svr_chr_payment_uuid =
    BLE_UUID128_INIT(0x67, 0x79, 0x7b, 0xf2, 0xf5, 0xf3, 0x82, 0xab,
                     0xa2, 0x4b, 0x6a, 0xfd, 0x27, 0x29, 0xef, 0x45);

// Produce weight UUID: 9f50361c-8ce0-4655-9903-577ca0c7db68
static const ble_uuid128_t gatt_svr_chr_produce_weight_uuid =
    BLE_UUID128_INIT(0x68, 0xdb, 0xc7, 0xa0, 0x7c, 0x57, 0x03, 0x99,
                     0x55, 0x46, 0xe0, 0x8c, 0x1c, 0x36, 0x50, 0x9f);

// Item verification UUID: c7a12053-7add-4a60-bd43-af8f0d171dce
static const ble_uuid128_t gatt_svr_chr_item_verification_uuid =
    BLE_UUID128_INIT(0xce, 0x1d, 0x17, 0x0d, 0x8f, 0xaf, 0x43, 0xbd,
                     0x60, 0x4a, 0xdd, 0x7a, 0x53, 0x20, 0xa1, 0xc7);

// Misc. UUID: b8ce8946-c4d4-486a-91fe-9fea2a670262
static const ble_uuid128_t gatt_svr_chr_misc_uuid =
    BLE_UUID128_INIT(0x62, 0x02, 0x67, 0x2a, 0xea, 0x9f, 0xfe, 0x91,
                     0x6a, 0x48, 0xd4, 0xc4, 0x46, 0x89, 0xce, 0xb8);

// RX characteristic
// UUID: 81de7ab2-7bb5-4a08-91ad-73165d9d2bb0
static const ble_uuid128_t gatt_svr_chr_rx_uuid =
    BLE_UUID128_INIT(0xb0, 0x2b, 0x9d, 0x5d, 0x16, 0x73, 0xad, 0x91,
                     0x08, 0x4a, 0xb5, 0x7b, 0xb2, 0x7a, 0xde, 0x81);

// BLE state
static bool ble_connected = false;
static uint16_t ble_conn_handle = 0;
static uint16_t upc_char_handle;
static uint16_t cart_tracking_char_handle;
static uint16_t payment_char_handle;
static uint16_t produce_weight_char_handle;
static uint16_t item_verification_char_handle;
static uint16_t misc_char_handle;
static uint16_t rx_char_handle;
static char device_name[32] = "ESP32_Barcode";

// Subscription tracking
static bool cart_tracking_notify_enabled = false;
static bool upc_notify_enabled = false;
static bool payment_notify_enabled = false;
static bool produce_weight_notify_enabled = false;
static bool item_verification_notify_enabled = false;
static bool misc_notify_enabled = false;

// RX callback and queue
static ble_rx_callback_t ble_rx_callback = NULL;
static QueueHandle_t ble_rx_queue = NULL;

// Forward declarations
static int gatt_svr_chr_access_barcode(uint16_t conn_handle, uint16_t attr_handle,
                                       struct ble_gatt_access_ctxt *ctxt, void *arg);
static void ble_advertise(void);

// GATT service definition
static const struct ble_gatt_svc_def gatt_svr_svcs[] = {
    {
        // Cartediem Service
        .type = BLE_GATT_SVC_TYPE_PRIMARY,
        .uuid = &gatt_svr_svc_cartediem_uuid.u,
        .characteristics = (struct ble_gatt_chr_def[]) {
            {
                // UPC Characteristic (device sends barcode data to client)
                .uuid = &gatt_svr_chr_upc_uuid.u,
                .access_cb = gatt_svr_chr_access_barcode,
                .flags = BLE_GATT_CHR_F_NOTIFY,
                .val_handle = &upc_char_handle,
            },
            {
                // Cart tracking cart_tracking Characteristic
                .uuid = &gatt_svr_chr_cart_tracking_uuid.u,
                .access_cb = gatt_svr_chr_access_barcode,
                .flags = BLE_GATT_CHR_F_NOTIFY,
                .val_handle = &cart_tracking_char_handle,
            },
            {
                // Payment status Characteristic
                .uuid = &gatt_svr_chr_payment_uuid.u,
                .access_cb = gatt_svr_chr_access_barcode,
                .flags = BLE_GATT_CHR_F_NOTIFY,
                .val_handle = &payment_char_handle,
            },
            {
                // Produce weight Characteristic
                .uuid = &gatt_svr_chr_produce_weight_uuid.u,
                .access_cb = gatt_svr_chr_access_barcode,
                .flags = BLE_GATT_CHR_F_NOTIFY,
                .val_handle = &produce_weight_char_handle,
            },
            {
                // Item verification Characteristic
                .uuid = &gatt_svr_chr_item_verification_uuid.u,
                .access_cb = gatt_svr_chr_access_barcode,
                .flags = BLE_GATT_CHR_F_NOTIFY,
                .val_handle = &item_verification_char_handle,
            },
            {
                // Misc. Characteristic
                .uuid = &gatt_svr_chr_misc_uuid.u,
                .access_cb = gatt_svr_chr_access_barcode,
                .flags = BLE_GATT_CHR_F_NOTIFY,
                .val_handle = &misc_char_handle,
            },
            {
                // RX Characteristic (optional - device receives data from client)
                .uuid = &gatt_svr_chr_rx_uuid.u,
                .access_cb = gatt_svr_chr_access_barcode,
                .flags = BLE_GATT_CHR_F_WRITE | BLE_GATT_CHR_F_WRITE_NO_RSP,
                .val_handle = &rx_char_handle,
            },
            {
                0,
            }
        },
    },
    {
        0, // No more services
    },
};

/**
 * @brief Handle GATT characteristic access for all BLE characteristics
 */
static int gatt_svr_chr_access_barcode(uint16_t conn_handle, uint16_t attr_handle,
                                       struct ble_gatt_access_ctxt *ctxt, void *arg)
{
    switch (ctxt->op) {
        case BLE_GATT_ACCESS_OP_READ_CHR:
            ESP_LOGI(TAG, "GATT read characteristic");
            return 0;

        case BLE_GATT_ACCESS_OP_WRITE_CHR:
            ESP_LOGI(TAG, "GATT write characteristic, len=%d", ctxt->om->om_len);

            // Check if this is the RX characteristic
            if (attr_handle == rx_char_handle) {
                // Extract data from mbuf
                uint16_t data_len = OS_MBUF_PKTLEN(ctxt->om);
                if (data_len > 0 && data_len <= 512) {
                    // Create a temporary buffer for the received data
                    uint8_t rx_data[513];  // +1 for null terminator
                    int rc = ble_hs_mbuf_to_flat(ctxt->om, rx_data, data_len, NULL);

                    if (rc == 0) {
                        rx_data[data_len] = '\0';  // Null terminate
                        ESP_LOGI(TAG, "BLE RX data received: %s", (char *)rx_data);

                        // Call callback if registered
                        if (ble_rx_callback != NULL) {
                            ble_rx_callback((const char *)rx_data, data_len);
                        }
                    }
                }
            }
            return 0;

        default:
            return BLE_ATT_ERR_UNLIKELY;
    }
}

/**
 * @brief Handle BLE GAP events (connections, disconnections, etc.)
 */
static int ble_gap_event(struct ble_gap_event *event, void *arg)
{
    struct ble_gap_conn_desc desc;
    int rc;

    switch (event->type) {
        case BLE_GAP_EVENT_CONNECT:
            ESP_LOGI(TAG, "Connection %s; status=%d",
                     event->connect.status == 0 ? "established" : "failed",
                     event->connect.status);

            if (event->connect.status == 0) {
                rc = ble_gap_conn_find(event->connect.conn_handle, &desc);
                if (rc == 0) {
                    ESP_LOGI(TAG, "Connected to %02x:%02x:%02x:%02x:%02x:%02x",
                             desc.peer_id_addr.val[5], desc.peer_id_addr.val[4],
                             desc.peer_id_addr.val[3], desc.peer_id_addr.val[2],
                             desc.peer_id_addr.val[1], desc.peer_id_addr.val[0]);
                    ble_connected = true;
                    ble_conn_handle = event->connect.conn_handle;
                }
            } else {
                // Connection failed; resume advertising
                ble_advertise();
            }
            return 0;

        case BLE_GAP_EVENT_DISCONNECT:
            ESP_LOGI(TAG, "Disconnect; reason=%d", event->disconnect.reason);
            ble_connected = false;
            ble_conn_handle = 0;
            
            // Resume advertising
            ble_advertise();
            return 0;

        case BLE_GAP_EVENT_CONN_UPDATE:
            ESP_LOGI(TAG, "Connection updated; status=%d", event->conn_update.status);
            return 0;

        case BLE_GAP_EVENT_ADV_COMPLETE:
            ESP_LOGI(TAG, "Advertise complete; reason=%d", event->adv_complete.reason);
            ble_advertise();
            return 0;

        case BLE_GAP_EVENT_MTU:
            ESP_LOGI(TAG, "MTU update event; conn_handle=%d cid=%d mtu=%d",
                     event->mtu.conn_handle,
                     event->mtu.channel_id,
                     event->mtu.value);
            return 0;

        case BLE_GAP_EVENT_SUBSCRIBE:
            ESP_LOGI(TAG, "Subscribe event; conn_handle=%d attr_handle=%d "
                          "reason=%d prevn=%d curn=%d previ=%d curi=%d",
                     event->subscribe.conn_handle,
                     event->subscribe.attr_handle,
                     event->subscribe.reason,
                     event->subscribe.prev_notify,
                     event->subscribe.cur_notify,
                     event->subscribe.prev_indicate,
                     event->subscribe.cur_indicate);

            // Track subscription status for each characteristic
            if (event->subscribe.attr_handle == upc_char_handle) {
                upc_notify_enabled = event->subscribe.cur_notify;
                ESP_LOGI(TAG, "UPC characteristic notify: %s", event->subscribe.cur_notify ? "enabled" : "disabled");
            } else if (event->subscribe.attr_handle == cart_tracking_char_handle) {
                cart_tracking_notify_enabled = event->subscribe.cur_notify;
                ESP_LOGI(TAG, "Cart Tracking characteristic notify: %s", event->subscribe.cur_notify ? "enabled" : "disabled");
            } else if (event->subscribe.attr_handle == payment_char_handle) {
                payment_notify_enabled = event->subscribe.cur_notify;
                ESP_LOGI(TAG, "Payment characteristic notify: %s", event->subscribe.cur_notify ? "enabled" : "disabled");
            } else if (event->subscribe.attr_handle == produce_weight_char_handle) {
                produce_weight_notify_enabled = event->subscribe.cur_notify;
                ESP_LOGI(TAG, "Produce weight characteristic notify: %s", event->subscribe.cur_notify ? "enabled" : "disabled");
            } else if (event->subscribe.attr_handle == item_verification_char_handle) {
                item_verification_notify_enabled = event->subscribe.cur_notify;
                ESP_LOGI(TAG, "Item verification characteristic notify: %s", event->subscribe.cur_notify ? "enabled" : "disabled");
            } else if (event->subscribe.attr_handle == misc_char_handle) {
                misc_notify_enabled = event->subscribe.cur_notify;
                ESP_LOGI(TAG, "Misc characteristic notify: %s", event->subscribe.cur_notify ? "enabled" : "disabled");
            }
            return 0;
    }

    return 0;
}

/**
 * @brief Start BLE advertisement
 */
static void ble_advertise(void)
{
    struct ble_gap_adv_params adv_params;
    struct ble_hs_adv_fields fields;
    int rc;

    // Set the advertisement data
    memset(&fields, 0, sizeof fields);
    
    fields.flags = BLE_HS_ADV_F_DISC_GEN | BLE_HS_ADV_F_BREDR_UNSUP;
    
    fields.name = (uint8_t *)device_name;
    fields.name_len = strlen(device_name);
    fields.name_is_complete = 1;

    rc = ble_gap_adv_set_fields(&fields);
    if (rc != 0) {
        ESP_LOGE(TAG, "Error setting advertisement data; rc=%d", rc);
        return;
    }

    // Set scan response data with UUID
    memset(&fields, 0, sizeof fields);
    fields.uuids128 = &gatt_svr_svc_cartediem_uuid;
    fields.num_uuids128 = 1;
    fields.uuids128_is_complete = 1;

    rc = ble_gap_adv_rsp_set_fields(&fields);
    if (rc != 0) {
        ESP_LOGE(TAG, "Error setting scan response data; rc=%d", rc);
        // Continue anyway - scan response is optional
    }

    // Begin advertising
    memset(&adv_params, 0, sizeof adv_params);
    adv_params.conn_mode = BLE_GAP_CONN_MODE_UND;
    adv_params.disc_mode = BLE_GAP_DISC_MODE_GEN;
    
    rc = ble_gap_adv_start(BLE_OWN_ADDR_PUBLIC, NULL, BLE_HS_FOREVER,
                          &adv_params, ble_gap_event, NULL);
    if (rc != 0) {
        ESP_LOGE(TAG, "Error enabling advertisement; rc=%d", rc);
        return;
    }
    
    ESP_LOGI(TAG, "Advertising started");
}

/**
 * @brief Called when BLE host stack syncs
 */
static void ble_on_sync(void)
{
    int rc;
    
    // Make sure we have proper identity address set (public preferred)
    rc = ble_hs_util_ensure_addr(0);
    if (rc != 0) {
        ESP_LOGE(TAG, "Error ensuring address; rc=%d", rc);
        return;
    }

    // Print device address
    uint8_t addr_type;
    uint8_t addr[6];
    rc = ble_hs_id_infer_auto(0, &addr_type);
    if (rc != 0) {
        ESP_LOGE(TAG, "Error determining address type; rc=%d", rc);
    } else {
        rc = ble_hs_id_copy_addr(addr_type, addr, NULL);
        if (rc == 0) {
            ESP_LOGI(TAG, "Device Address: %02x:%02x:%02x:%02x:%02x:%02x",
                     addr[5], addr[4], addr[3], addr[2], addr[1], addr[0]);
        }
    }

    // Give the stack a moment to fully initialize
    vTaskDelay(pdMS_TO_TICKS(100));

    // Begin advertising
    ble_advertise();
}

/**
 * @brief Called when BLE host stack resets
 */
static void ble_on_reset(int reason)
{
    ESP_LOGE(TAG, "Resetting state; reason=%d", reason);
}

/**
 * @brief NimBLE host task
 */
static void nimble_host_task(void *param)
{
    ESP_LOGI(TAG, "BLE Host Task Started");
    nimble_port_run();
    nimble_port_freertos_deinit();
}

esp_err_t ble_init(const char *name)
{
    esp_err_t ret;

    if (name) {
        strncpy(device_name, name, sizeof(device_name) - 1);
        device_name[sizeof(device_name) - 1] = '\0';
    }

    // Initialize NVS
    ret = nvs_flash_init();
    if (ret == ESP_ERR_NVS_NO_FREE_PAGES || ret == ESP_ERR_NVS_NEW_VERSION_FOUND) {
        ESP_ERROR_CHECK(nvs_flash_erase());
        ret = nvs_flash_init();
    }
    ESP_ERROR_CHECK(ret);

    // Initialize NimBLE
    ESP_ERROR_CHECK(nimble_port_init());
    
    // Initialize the NimBLE host configuration
    ble_hs_cfg.sync_cb = ble_on_sync;
    ble_hs_cfg.reset_cb = ble_on_reset;
    ble_hs_cfg.gatts_register_cb = NULL;
    ble_hs_cfg.store_status_cb = NULL;

    // Set device name
    ret = ble_svc_gap_device_name_set(device_name);
    if (ret != 0) {
        ESP_LOGE(TAG, "Error setting device name; rc=%d", ret);
        return ESP_FAIL;
    }

    // Initialize GATT service
    ret = ble_gatts_count_cfg(gatt_svr_svcs);
    if (ret != 0) {
        ESP_LOGE(TAG, "Error counting GATT configuration; rc=%d", ret);
        return ESP_FAIL;
    }

    ret = ble_gatts_add_svcs(gatt_svr_svcs);
    if (ret != 0) {
        ESP_LOGE(TAG, "Error adding GATT services; rc=%d", ret);
        return ESP_FAIL;
    }

    // Initialize GAP and GATT services
    ble_svc_gap_init();
    ble_svc_gatt_init();

    // Start the NimBLE host task
    nimble_port_freertos_init(nimble_host_task);
    
    ESP_LOGI(TAG, "BLE barcode service initialized as '%s'", device_name);
    return ESP_OK;
}

/**
 * @brief Send data to connected BLE client via notification
 */
static esp_err_t ble_send_data(uint16_t char_handle, const char *data, const char *data_type, bool is_subscribed)
{
    if (!ble_connected) {
        ESP_LOGW(TAG, "Cannot send %s: no client connected", data_type);
        return ESP_ERR_INVALID_STATE;
    }

    if (!is_subscribed) {
        ESP_LOGW(TAG, "Cannot send %s: client not subscribed to notifications", data_type);
        return ESP_ERR_INVALID_STATE;
    }

    if (!data) {
        return ESP_ERR_INVALID_ARG;
    }

    size_t len = strlen(data);
    if (len == 0) {
        return ESP_ERR_INVALID_ARG;
    }

    // Create mbuf for notification
    struct os_mbuf *om;
    om = ble_hs_mbuf_from_flat((const void *)data, len);
    if (!om) {
        ESP_LOGE(TAG, "Failed to allocate mbuf for %s", data_type);
        return ESP_ERR_NO_MEM;
    }

    // Send notification
    int rc = ble_gatts_notify_custom(ble_conn_handle, char_handle, om);
    if (rc != 0) {
        ESP_LOGE(TAG, "Failed to send %s notification; rc=%d", data_type, rc);
        // Don't free om here as ble_gatts_notify_custom takes ownership on success/failure
        return ESP_FAIL;
    }

    ESP_LOGI(TAG, "Sent %s via BLE: %s", data_type, data);
    return ESP_OK;
}

esp_err_t ble_send_barcode(const char *barcode_data)
{
    return ble_send_data(upc_char_handle, barcode_data, "barcode", upc_notify_enabled);
}

esp_err_t ble_send_cart_tracking(const char *cart_tracking_data)
{
    return ble_send_data(cart_tracking_char_handle, cart_tracking_data, "cart_tracking", cart_tracking_notify_enabled);
}

esp_err_t ble_send_payment_status(const char *payment_status)
{
    return ble_send_data(payment_char_handle, payment_status, "payment status", payment_notify_enabled);
}

esp_err_t ble_send_produce_weight(const char *weight_data)
{
    return ble_send_data(produce_weight_char_handle, weight_data, "produce weight", produce_weight_notify_enabled);
}

esp_err_t ble_send_item_verification(const char *weight_data)
{
    return ble_send_data(item_verification_char_handle, weight_data, "item verification", item_verification_notify_enabled);
}

esp_err_t ble_send_misc_data(const char *misc_data)
{
    return ble_send_data(misc_char_handle, misc_data, "misc data", misc_notify_enabled);
}

bool ble_is_connected(void)
{
    return ble_connected;
}

void ble_register_rx_callback(ble_rx_callback_t callback)
{
    ble_rx_callback = callback;

    // Create RX queue if not already created (for queue-based reception)
    if (ble_rx_queue == NULL && callback != NULL) {
        // Define a proper struct type for queue items
        typedef struct {
            uint8_t data[512];
            uint16_t len;
        } ble_rx_msg_t;

        ble_rx_queue = xQueueCreate(4, sizeof(ble_rx_msg_t));
        if (ble_rx_queue == NULL) {
            ESP_LOGE(TAG, "Failed to create BLE RX queue");
            return;
        }
    }

    if (callback != NULL) {
        ESP_LOGI(TAG, "BLE RX callback registered");
    } else {
        ESP_LOGI(TAG, "BLE RX callback unregistered");
    }
}

void ble_deinit(void)
{
    int rc = nimble_port_stop();
    if (rc != 0) {
        ESP_LOGE(TAG, "Error stopping NimBLE; rc=%d", rc);
    }

    nimble_port_deinit();

    // Clean up RX queue
    if (ble_rx_queue != NULL) {
        vQueueDelete(ble_rx_queue);
        ble_rx_queue = NULL;
    }

    ESP_LOGI(TAG, "BLE barcode service deinitialized");
}
