felixlu4725/Carte-Diem/(commit log)

2025-12-08 Added cart interface
    [Barcode_scanner.kicad_sch, CartDiem_STM.kicad_pcb, CartDiem_STM.kicad_sch, GPS.kicad_sch, Hand Scanner Final.step, IMU.kicad_sch, LT1764AEQPBF.step, MF-MSMF010-2.step]
2025-12-20 Remove image from CAD README
    Removed an image from the README file.
2025-12-20 Add README for Carte Diem PCB details
    This README provides detailed information about the custom ESP32-S3-based PCB designed for the Carte Diem smart shopping cart system, including its features, design notes, and schematic images.
2025-12-20 Add README for Carte Diem mechanical CAD designs
    Added detailed documentation for the mechanical CAD designs, including an overview, key components, design considerations, fabrication notes, and status of the models.
2025-12-22 Added cart tracking repo
    [grocery_store_rfid2map.csv, rfid2map.csv, session.csv, session_1.csv, session_2.csv, session_3.csv, session_4.csv, session_5.csv]
